callumberry/Mobile-Robot/prototype/README.md

[Home](main)

# Cardboard Prototype
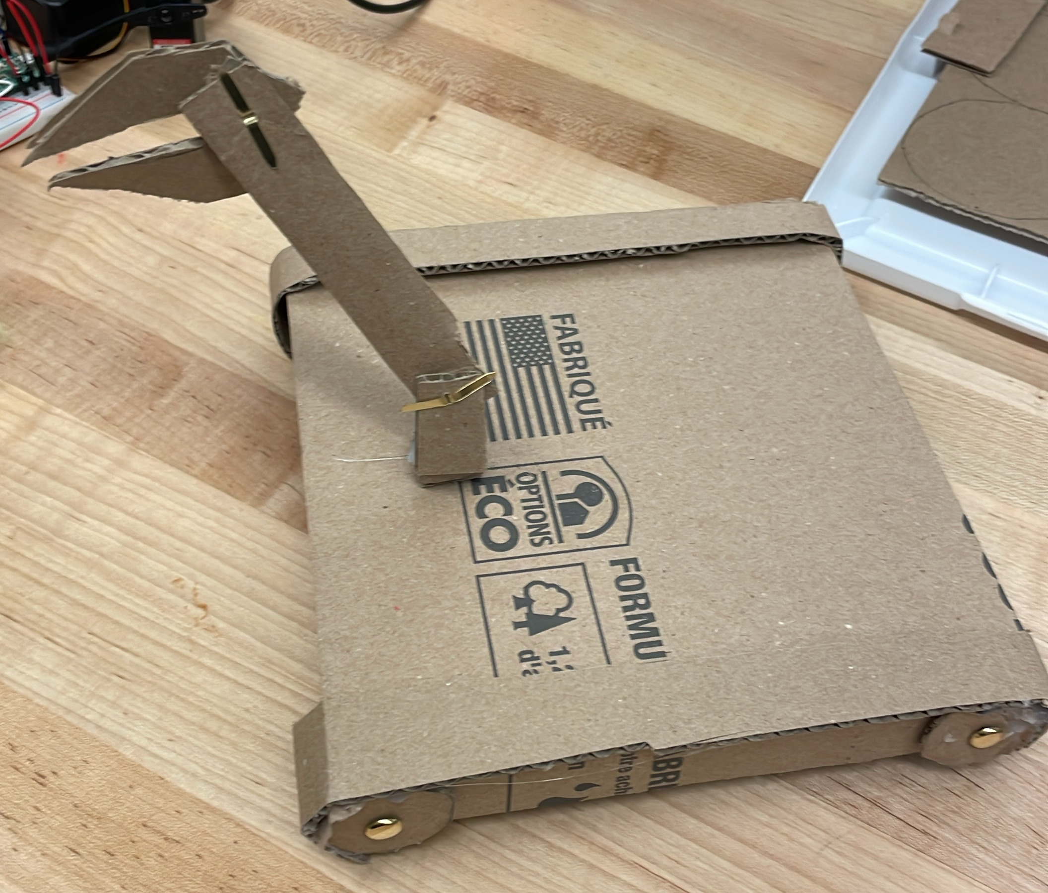
[picture p4: images/prototype/cardboardPro.jpeg]


# Electrical Schematic
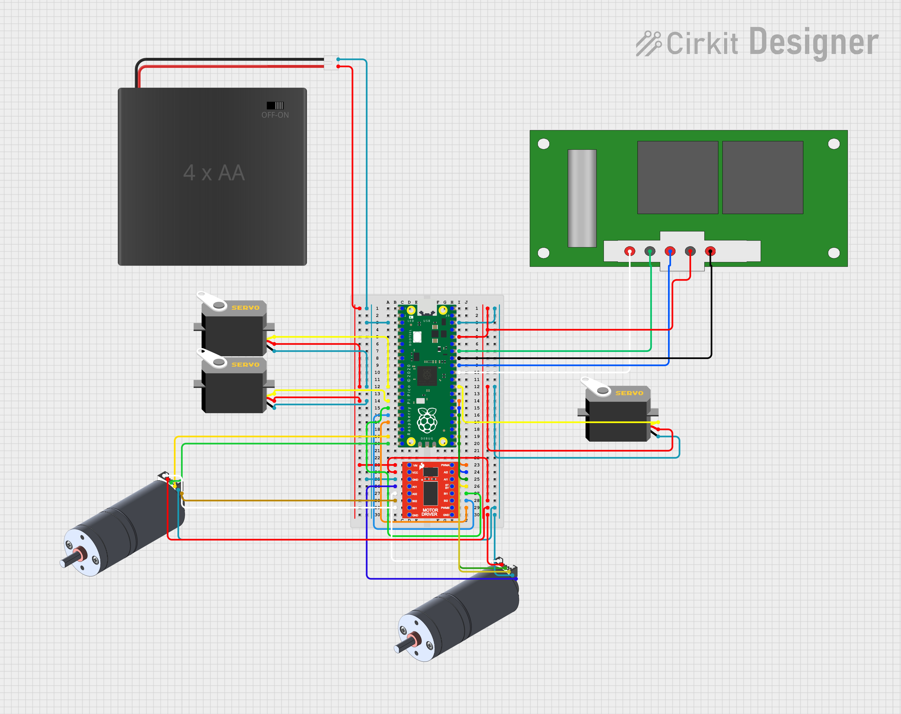
[picture p5: images/prototype/electricalSch.png]


# Electrical Wiring/
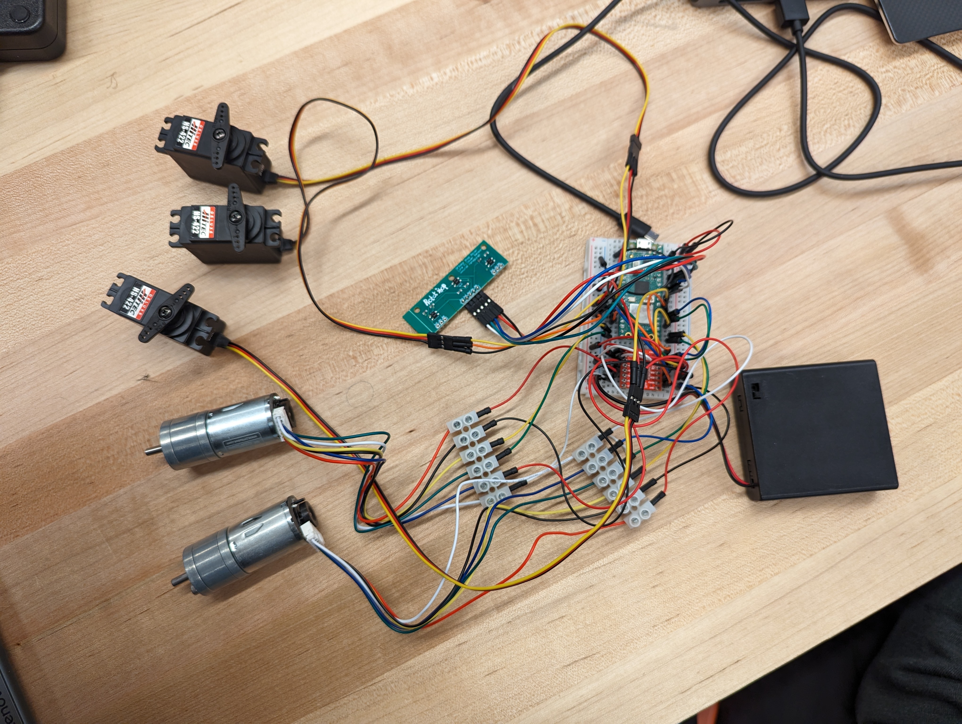
[picture p6: images/prototype/electrical.jpg]


# Arm V1


# Robot w/ Arm V2 + Claw
