callumberry/Mobile-Robot/design_files/CAD/README.md

[Home](main)

# Assembly Pictures
## Arm V1
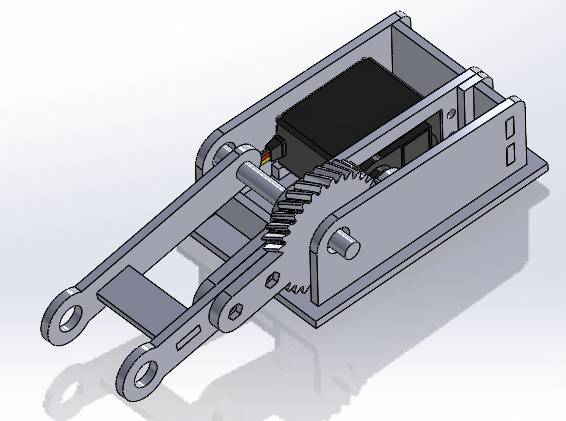
[picture p7: images/solidworks/armV1.png]


## Arm V2
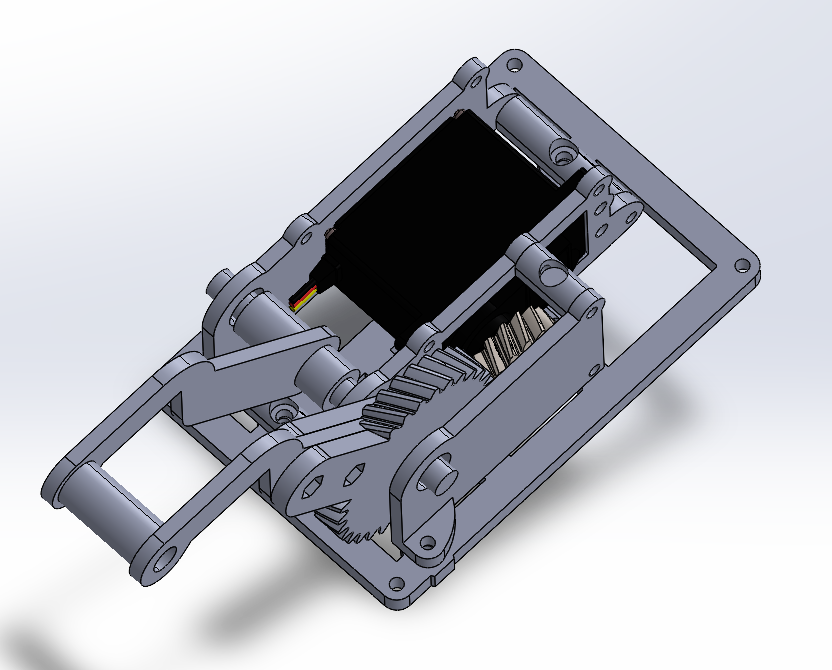
[picture p8: images/solidworks/armAssemblyV2.png]


## Claw
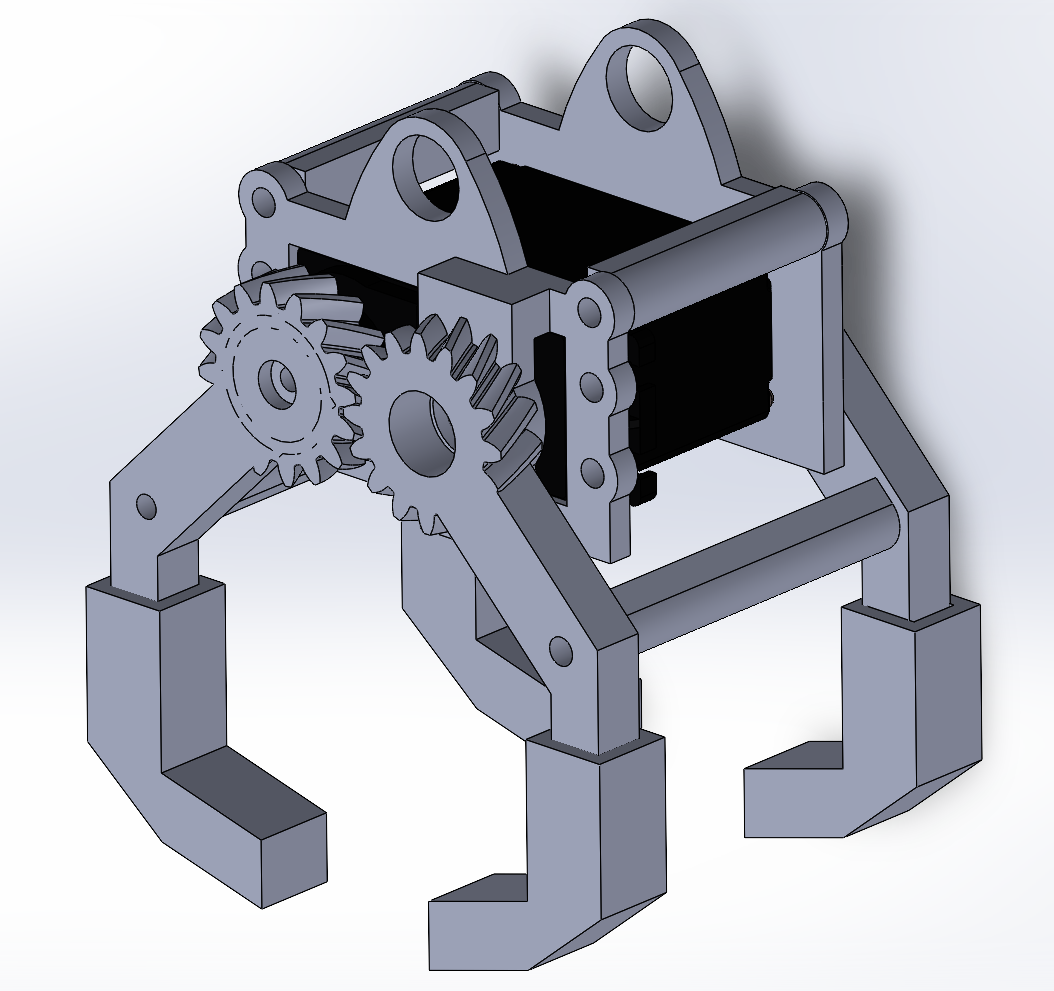
[picture p9: images/solidworks/clawAssembly.png]


## Robot
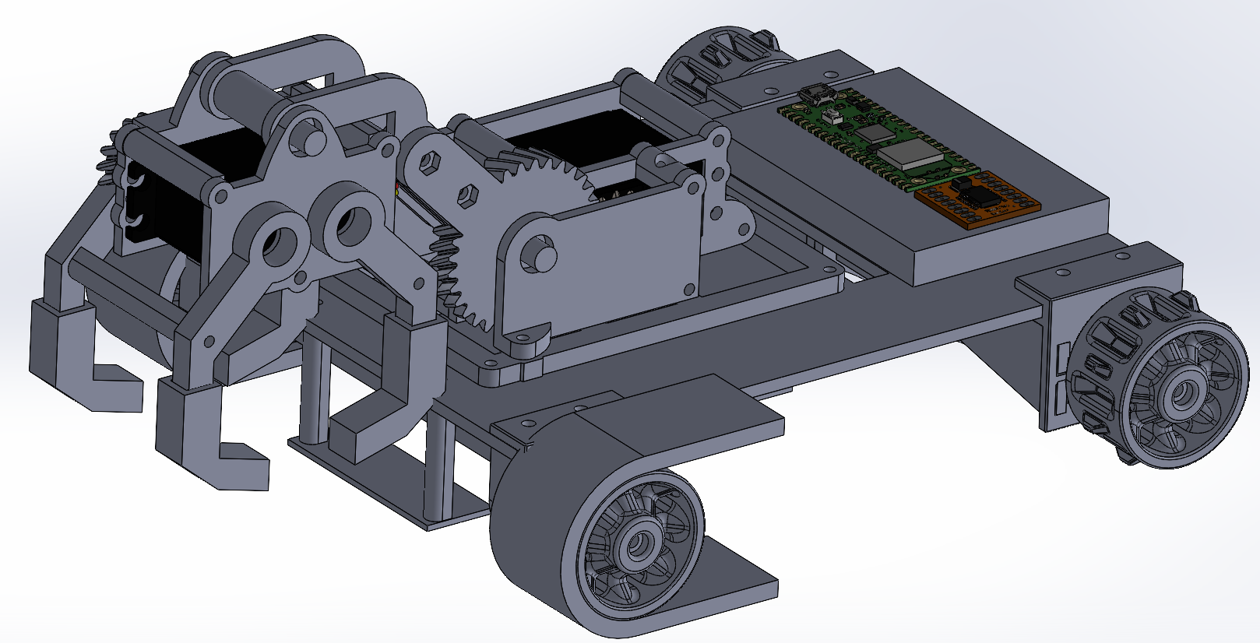
[picture p10: images/solidworks/robotAssembly.png]
