callumberry/Mobile-Robot/design_files/laser_cutting/README.md

[Home](main)

# Pictures
## Chassis
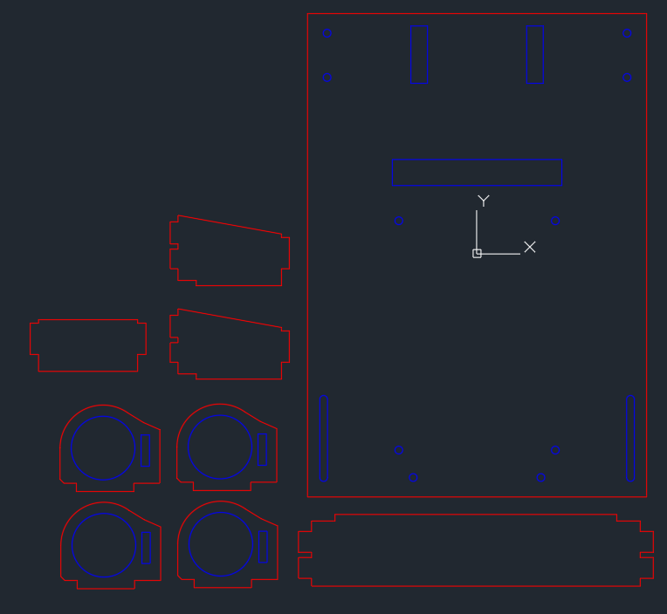
[picture p11: images/dwg/chassis.png]


## Arm V1
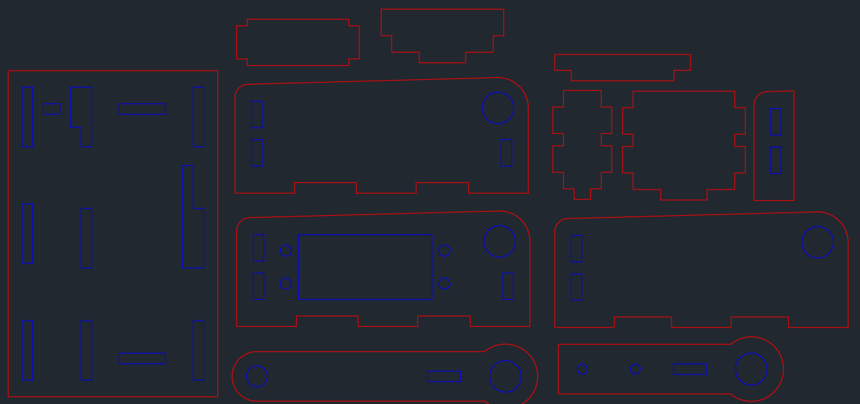
[picture p12: images/dwg/arm.png]


## Chassis and Arm Base V2
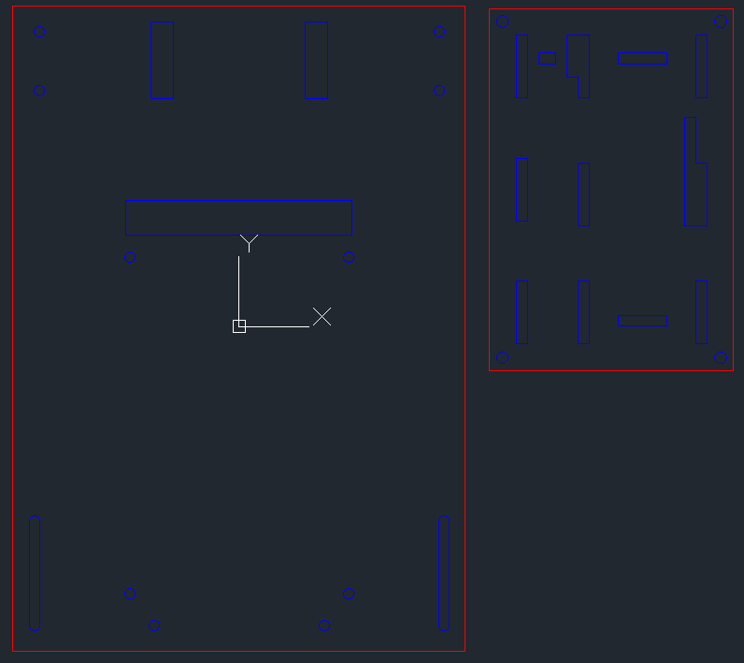
[picture p13: images/dwg/chassis_baseV2.png]
