callumberry/Mobile-Robot/design_files/CAD/Current/Arm/leftarm.SLDASM

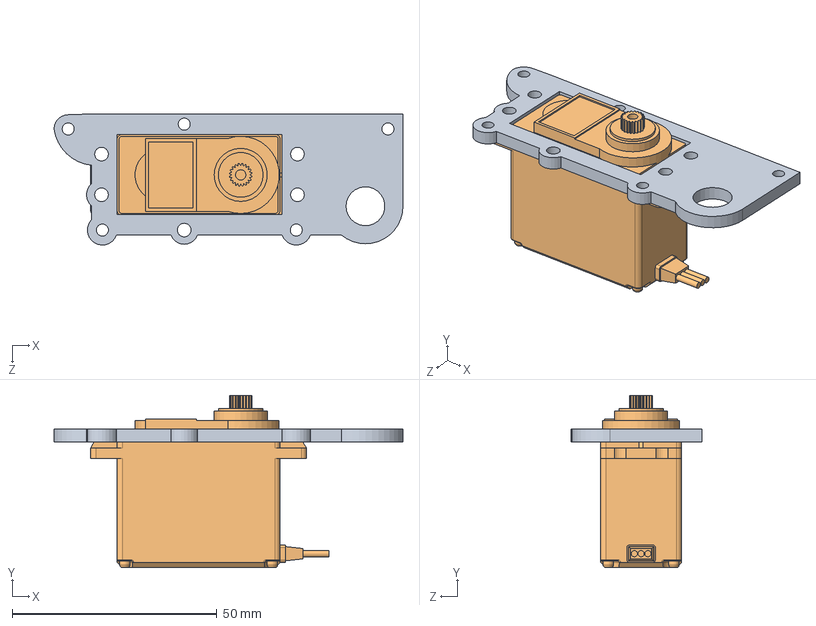
[picture p20: CAD file, 2024-03-31]
design_files/CAD/Current/Arm/leftarm.SLDASM
85.3 x 42.1 x 32.1 mm
HS-422_Servo
servoPlateV2
