callumberry/Mobile-Robot/design_files/CAD/Assemblies/DriveTrain.SLDASM

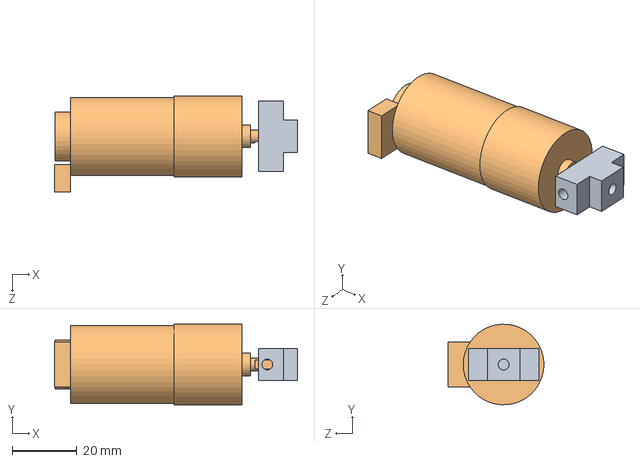
[picture p21: CAD file, 2024-03-23]
design_files/CAD/Assemblies/DriveTrain.SLDASM
75.0 x 24.9 x 29.5 mm
DC_Motor
GrubTestFinal
