callumberry/Mobile-Robot/design_files/CAD/Current/Other/linefollowing.SLDASM

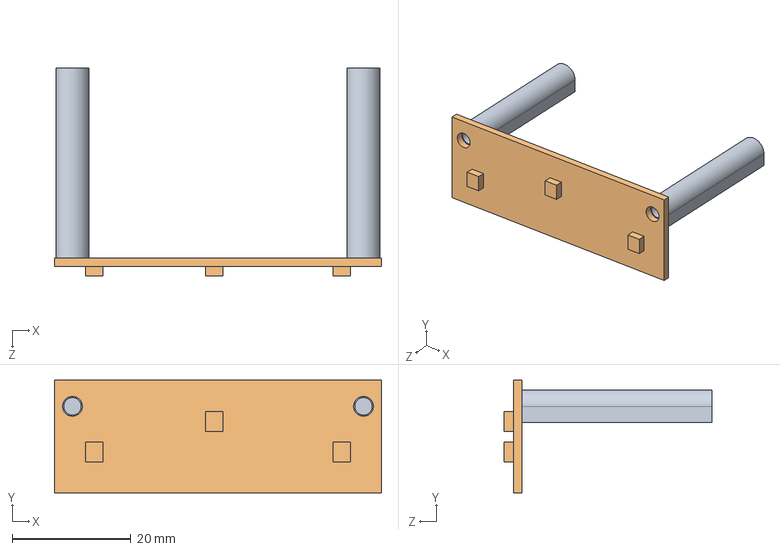
[picture p22: CAD file, 2024-03-31]
design_files/CAD/Current/Other/linefollowing.SLDASM
55.0 x 19.0 x 35.1 mm
sensor
sensorSpacer x 2
