callumberry/Mobile-Robot/design_files/CAD/Parts/ChassisTopIncomplete.SLDPRT

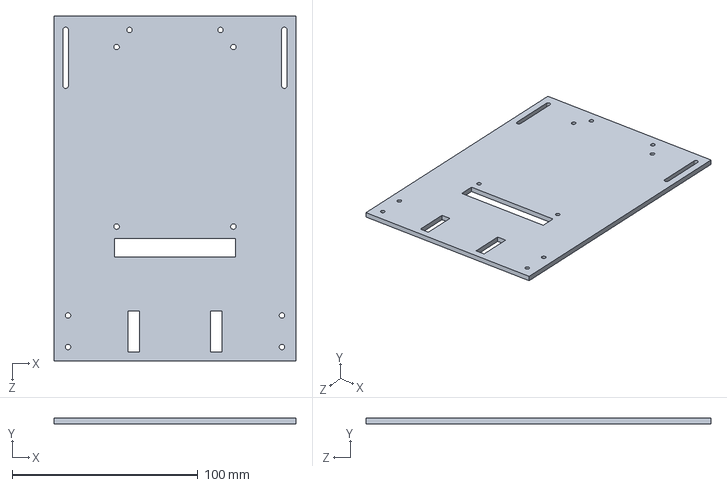
[picture p23: CAD file, 2024-03-31]
design_files/CAD/Parts/ChassisTopIncomplete.SLDPRT
130.0 x 3.17 x 185.5 mm
