callumberry/Mobile-Robot/design_files/CAD/Current/Arm/arm2.SLDASM

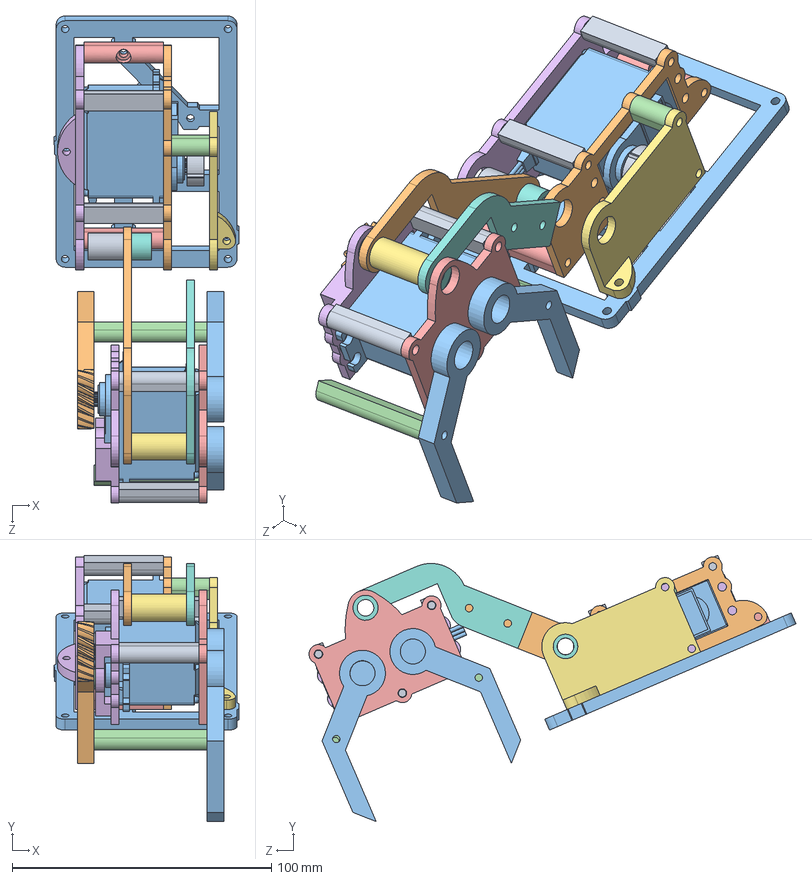
[picture p24: CAD file, 2024-03-31]
design_files/CAD/Current/Arm/arm2.SLDASM
71.2 x 102.6 x 187.7 mm
HS-422_Servo x 2
servoPlateV2
gearSmall x 2
Gearlinkage
GearPlate
servoPlateV2OtherSideBetter
ArmSupport x 2
ArmSupportGear
base
Newlinkage
linkageALign1
linkageALign2
gripperLinkageMiddel
gripperPlate
fingerPlateV2
fingersupprt x 2
roundFingerMotor x 2
smallGearWithservo
gripperSupport x 5
