callumberry/Mobile-Robot/design_files/CAD/Current/Gripper/clawRight.SLDASM

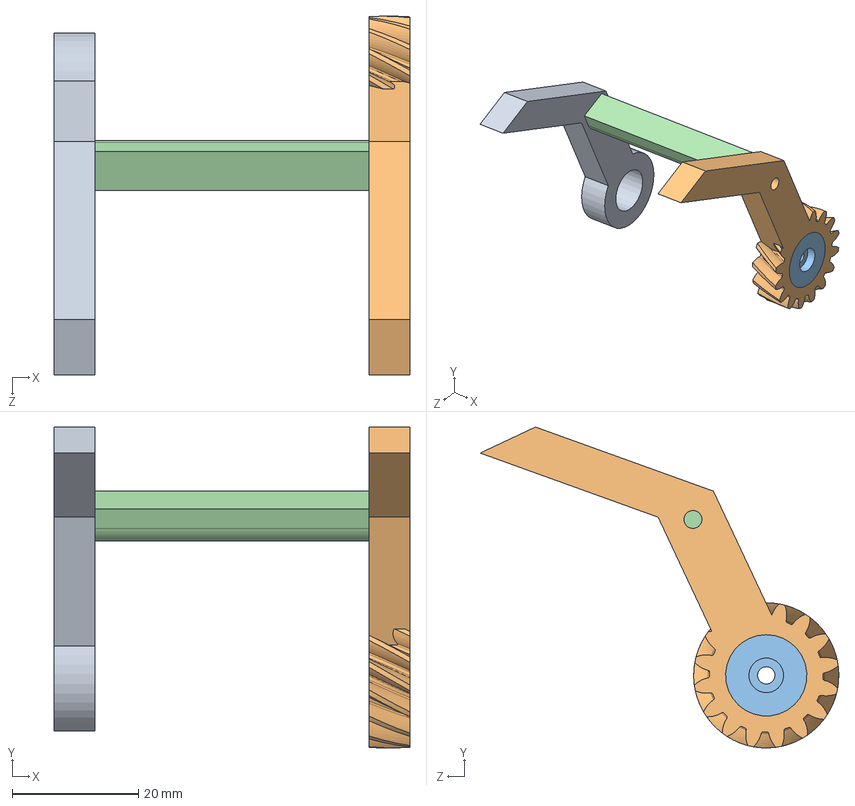
[picture p25: CAD file, 2024-03-31]
design_files/CAD/Current/Gripper/clawRight.SLDASM
56.5 x 50.9 x 56.9 mm
fingersupprt
gearSmall
smallGearWithservo
roundFingerMotor
