callumberry/Mobile-Robot/design_files/CAD/Current/Gripper/Gripper2.SLDASM

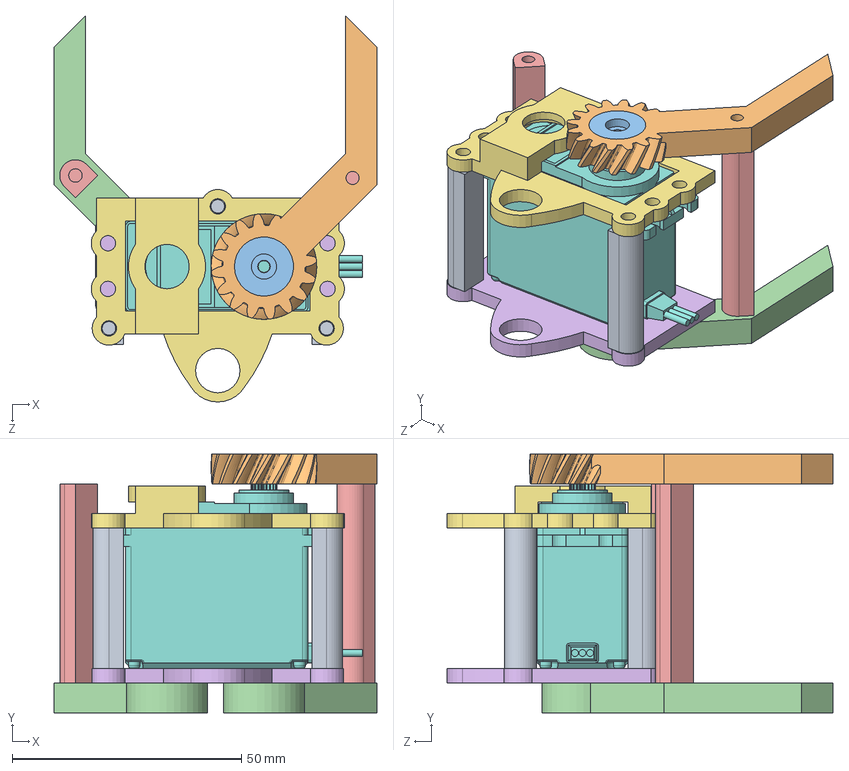
[picture p26: CAD file, 2024-03-31]
design_files/CAD/Current/Gripper/Gripper2.SLDASM
70.4 x 56.5 x 84.2 mm
HS-422_Servo
gripperPlate
fingerPlateV2
fingersupprt x 2
roundFingerMotor x 2
gearSmall
smallGearWithservo
gripperSupport x 3
