callumberry/Mobile-Robot/design_files/CAD/Current/Gripper/clawLeft.SLDASM

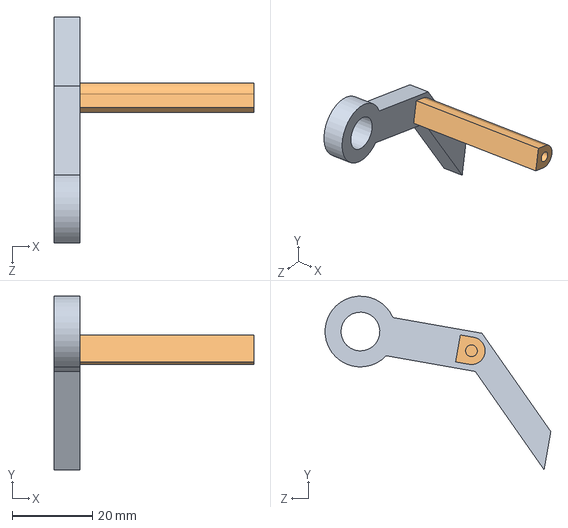
[picture p27: CAD file, 2024-03-31]
design_files/CAD/Current/Gripper/clawLeft.SLDASM
50.0 x 43.4 x 56.4 mm
fingersupprt
roundFingerMotor
