callumberry/Mobile-Robot/design_files/3D_printing/3mf/sleeves.3mf

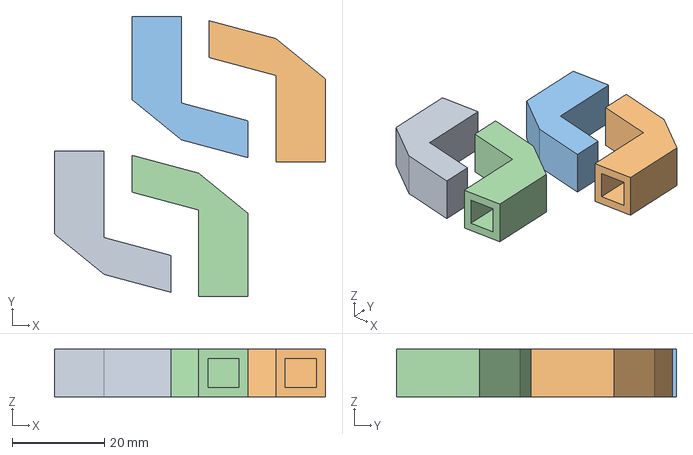
[picture p28: CAD file, 2024-03-31]
design_files/3D_printing/3mf/sleeves.3mf
58.8 x 60.7 x 10.4 mm
sleeve x 4
