callumberry/Mobile-Robot/design_files/CAD/Components/HS-422_Servo.SLDPRT

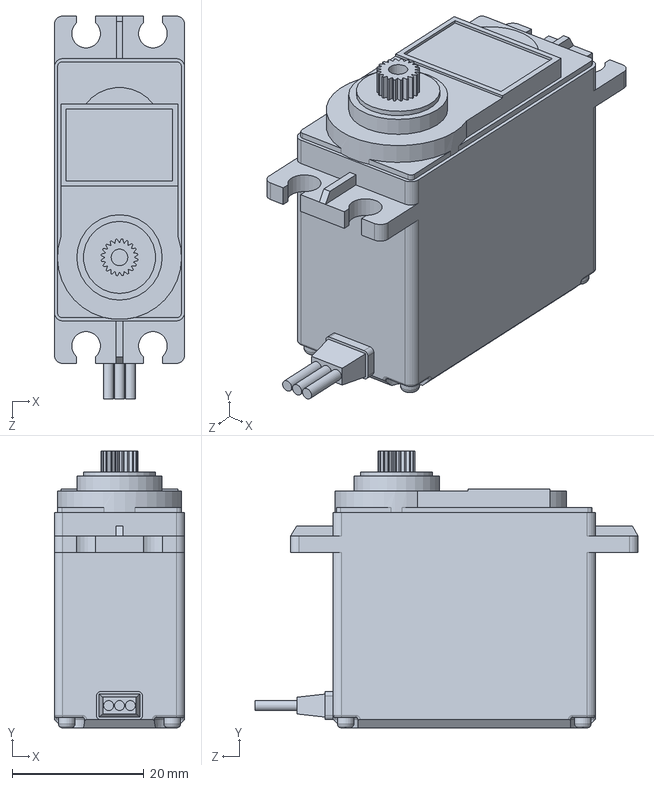
[picture p29: CAD file, 2024-03-23]
design_files/CAD/Components/HS-422_Servo.SLDPRT
19.8 x 42.1 x 58.2 mm
