callumberry/Mobile-Robot/design_files/CAD/Current/Gripper/fingersupprt.SLDPRT

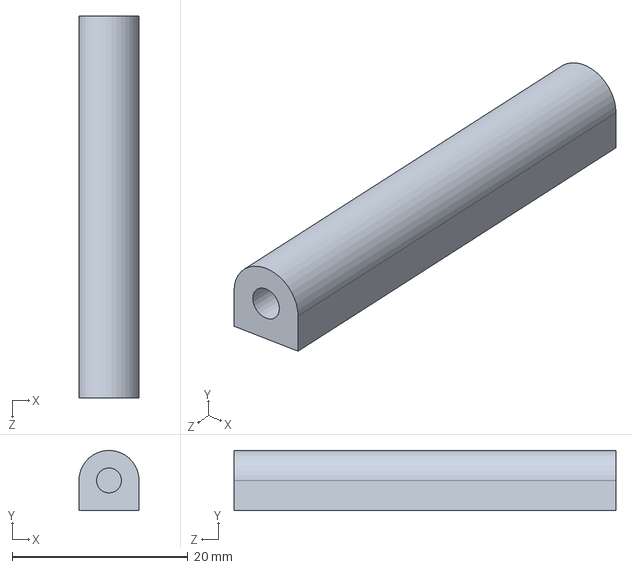
[picture p30: CAD file, 2024-03-31]
design_files/CAD/Current/Gripper/fingersupprt.SLDPRT
6.85 x 6.84 x 43.5 mm
