callumberry/Mobile-Robot/design_files/CAD/Current/linkageALign1.SLDPRT

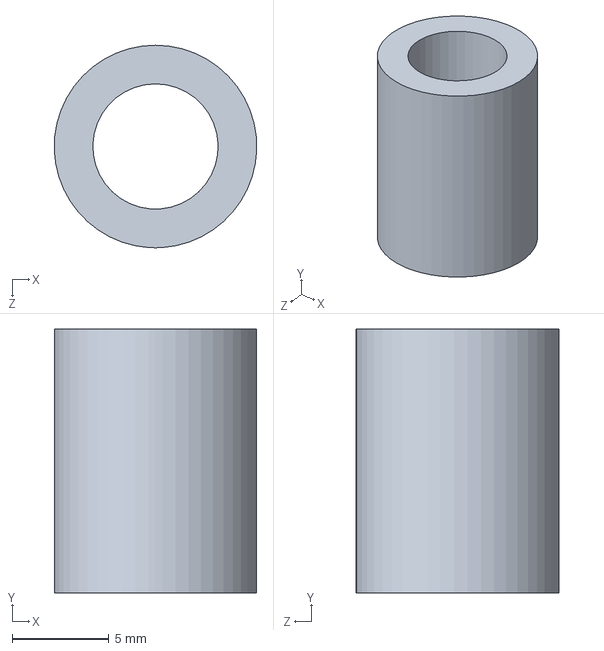
[picture p31: CAD file, 2024-03-31]
design_files/CAD/Current/linkageALign1.SLDPRT
10.5 x 13.6 x 10.5 mm
