callumberry/Mobile-Robot/design_files/CAD/Current/Other/endcap.SLDPRT

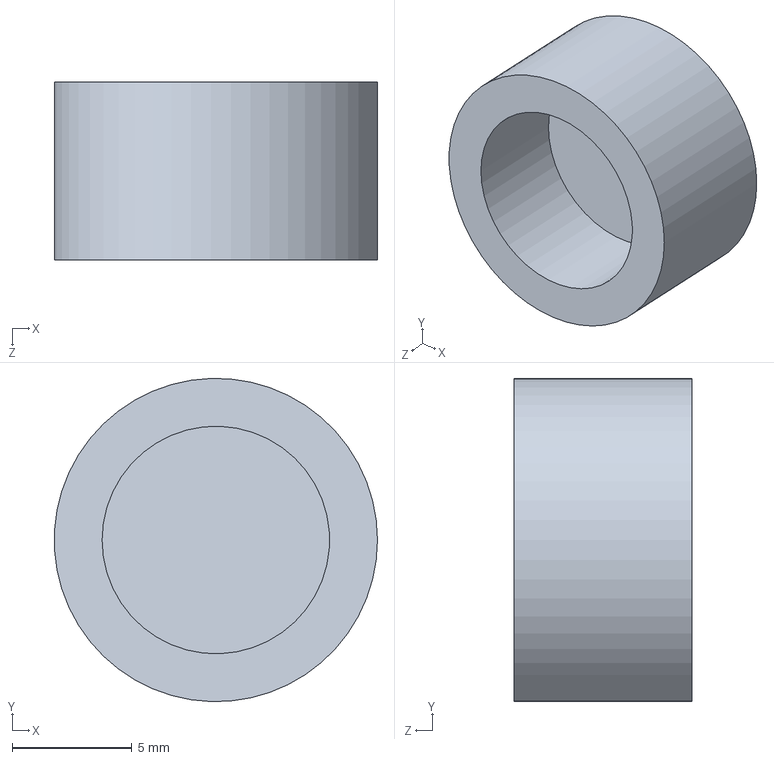
[picture p32: CAD file, 2024-03-31]
design_files/CAD/Current/Other/endcap.SLDPRT
13.5 x 13.5 x 7.43 mm
