callumberry/Mobile-Robot/design_files/CAD/Finished/TreadsFeb22_2024.3mf

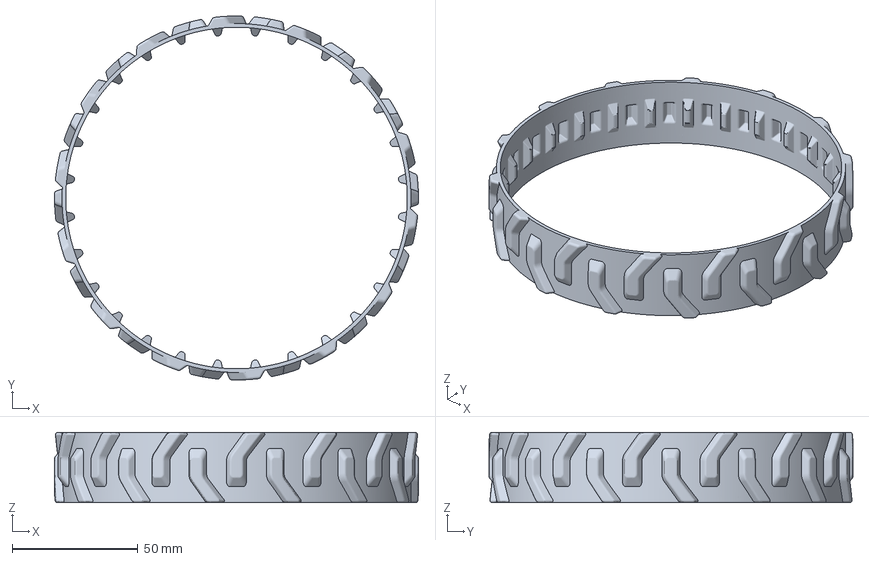
[picture p33: CAD file, 2024-03-31]
design_files/CAD/Finished/TreadsFeb22_2024.3mf
145.0 x 145.0 x 28.0 mm
