callumberry/Mobile-Robot/design_files/CAD/Parts/smallGearWithservo.SLDPRT

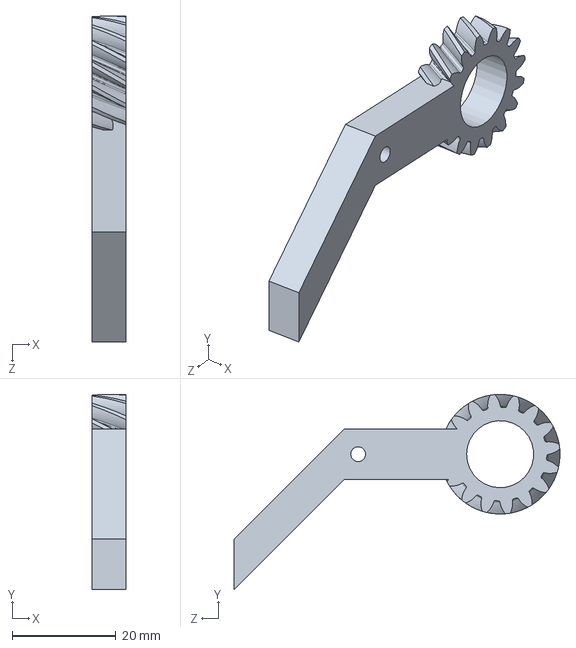
[picture p34: CAD file, 2024-03-31]
design_files/CAD/Parts/smallGearWithservo.SLDPRT
6.47 x 37.6 x 62.7 mm
