callumberry/Mobile-Robot/design_files/3D_printing/3mf/idlePincers.3mf

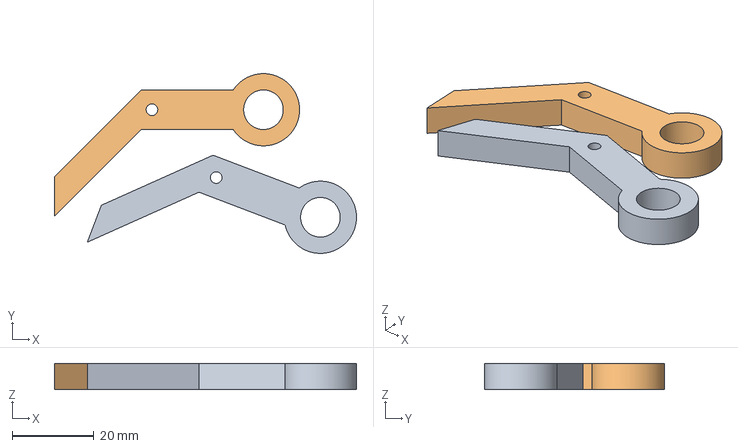
[picture p35: CAD file, 2024-03-31]
design_files/3D_printing/3mf/idlePincers.3mf
74.0 x 44.1 x 6.47 mm
roundFingerMotor x 2
