callumberry/Mobile-Robot/design_files/CAD/Components/DC_Motor.SLDPRT

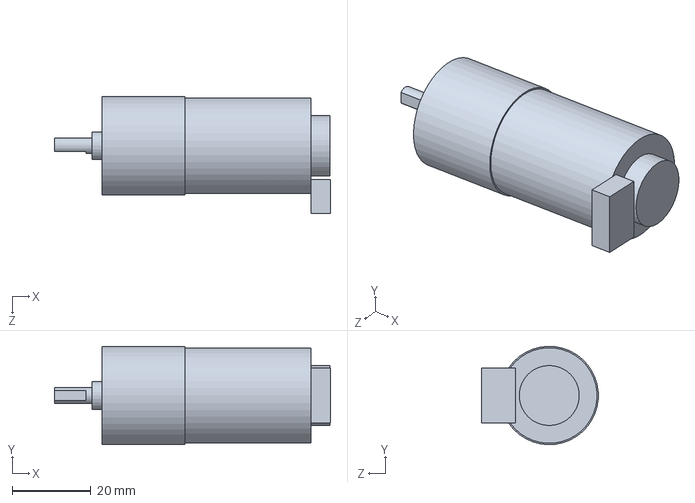
[picture p36: CAD file, 2024-01-29]
design_files/CAD/Components/DC_Motor.SLDPRT
69.9 x 24.9 x 29.5 mm
