callumberry/Mobile-Robot/design_files/CAD/Current/base.SLDPRT

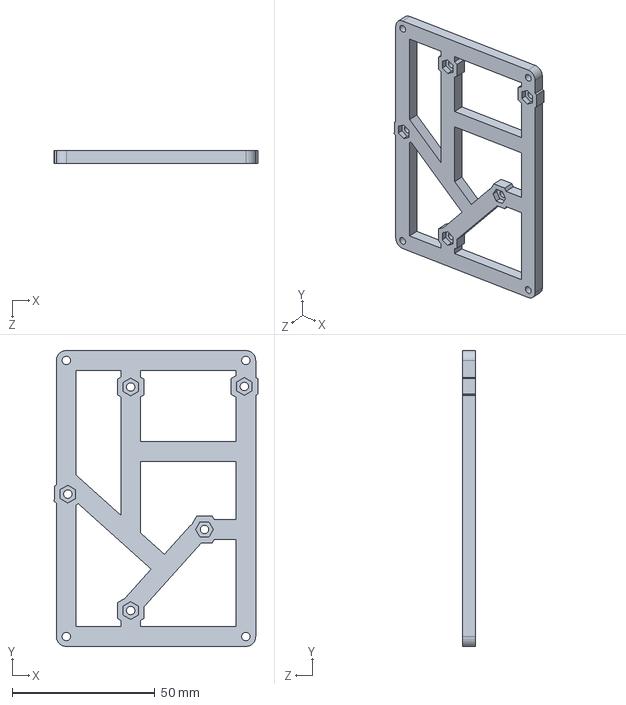
[picture p37: CAD file, 2024-03-31]
design_files/CAD/Current/base.SLDPRT
71.2 x 103.5 x 4.60 mm
