callumberry/Mobile-Robot/design_files/CAD/Current/Gripper/fingerPlateV2.SLDPRT

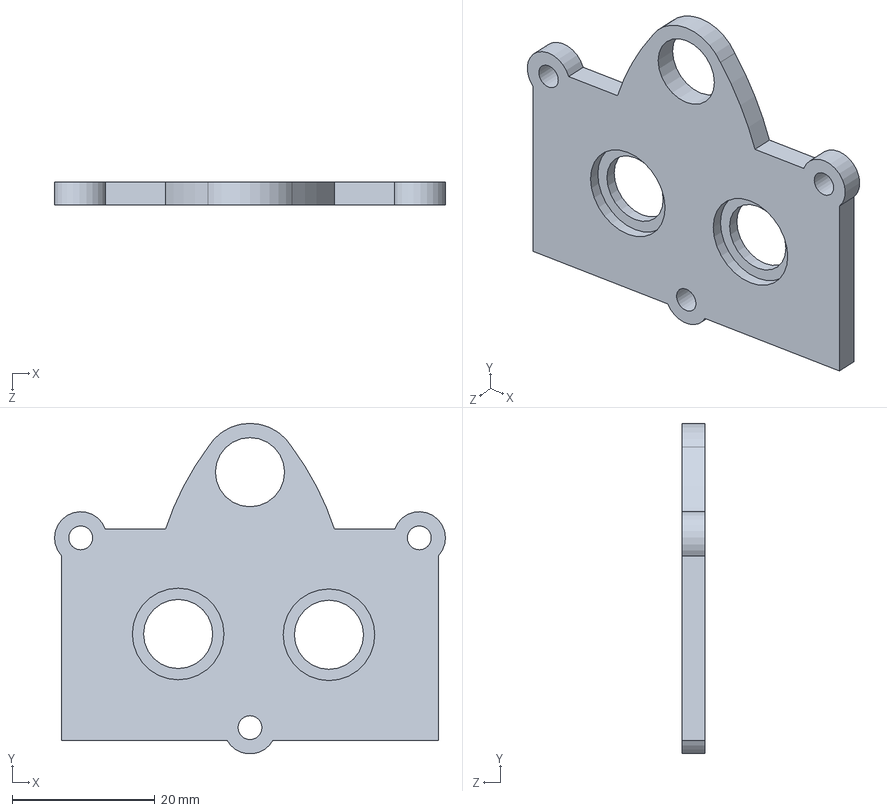
[picture p38: CAD file, 2024-03-31]
design_files/CAD/Current/Gripper/fingerPlateV2.SLDPRT
54.8 x 46.3 x 3.20 mm
