callumberry/Mobile-Robot/design_files/CAD/Xtra/ToleranceTests/hexTest.SLDPRT

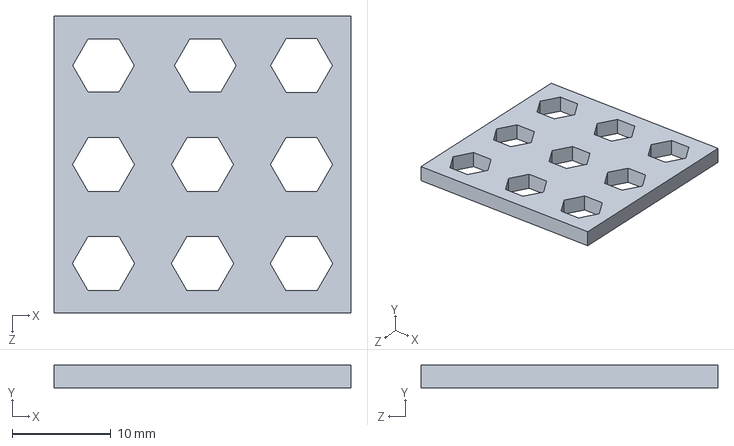
[picture p40: CAD file, 2024-03-23]
design_files/CAD/Xtra/ToleranceTests/hexTest.SLDPRT
30.0 x 2.30 x 30.0 mm
