callumberry/Mobile-Robot/design_files/3D_printing/3mf/armV2.3mf

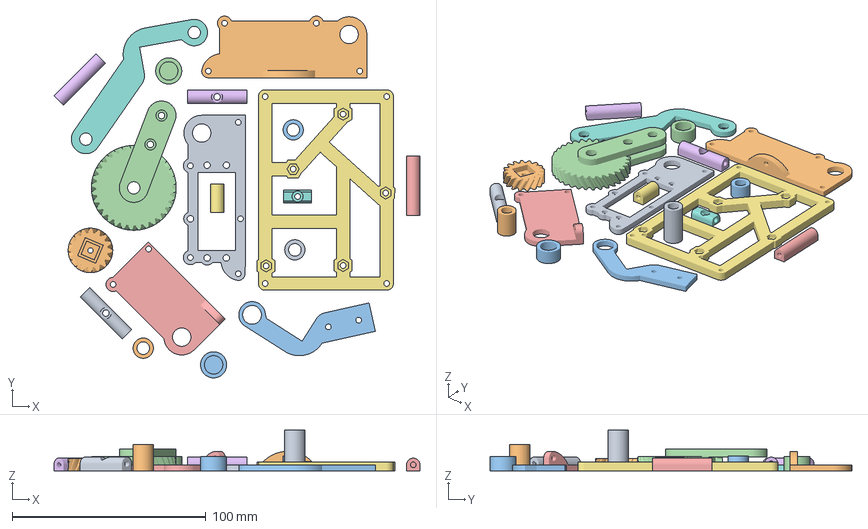
[picture p41: CAD file, 2024-03-31]
design_files/3D_printing/3mf/armV2.3mf
189.0 x 186.8 x 21.1 mm
print2
prnt3
endcap x 2
GearPlate
ArmSupport x 2
ArmSupportGear
ArmSupportGearScrew
motorGear
Gearlinkage
bigGear
gripperSupport x 2
base
Newlinkage
gripperLinkageMiddel
linkageALign1
linkageALign2
