callumberry/Mobile-Robot/design_files/CAD/Components/MotorDriver.SLDPRT

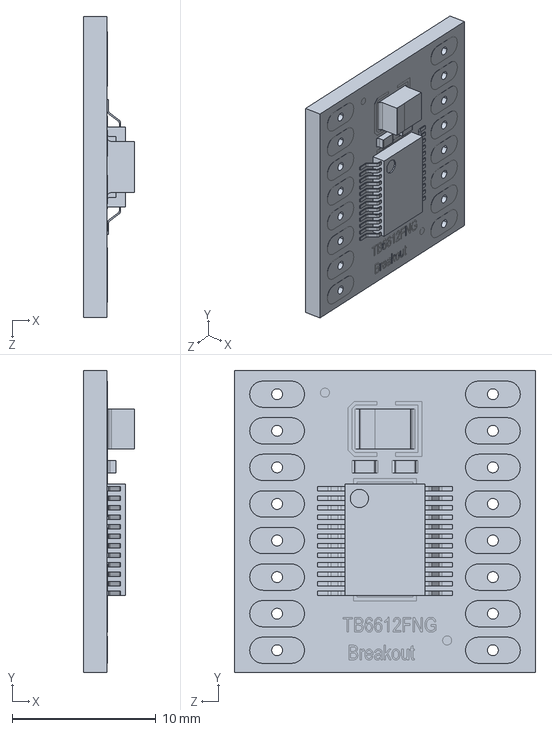
[picture p42: CAD file, 2024-01-29]
design_files/CAD/Components/MotorDriver.SLDPRT
3.57 x 21.0 x 20.9 mm
