callumberry/Mobile-Robot/design_files/CAD/Current/Arm/Gearlinkage.SLDPRT

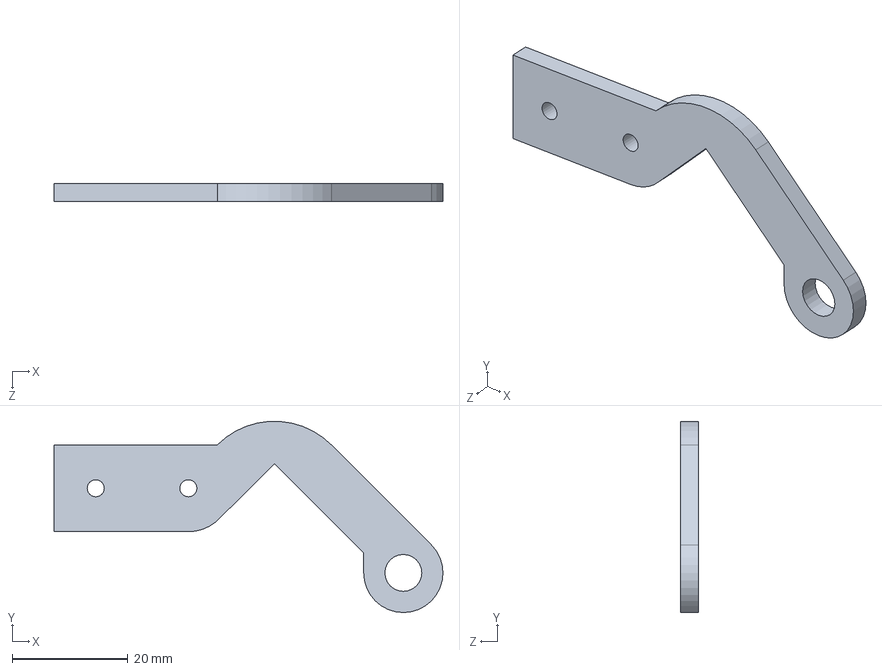
[picture p43: CAD file, 2024-03-31]
design_files/CAD/Current/Arm/Gearlinkage.SLDPRT
67.2 x 33.0 x 3.17 mm
