callumberry/Mobile-Robot/design_files/CAD/Current/Gripper/gripperSupport.SLDPRT

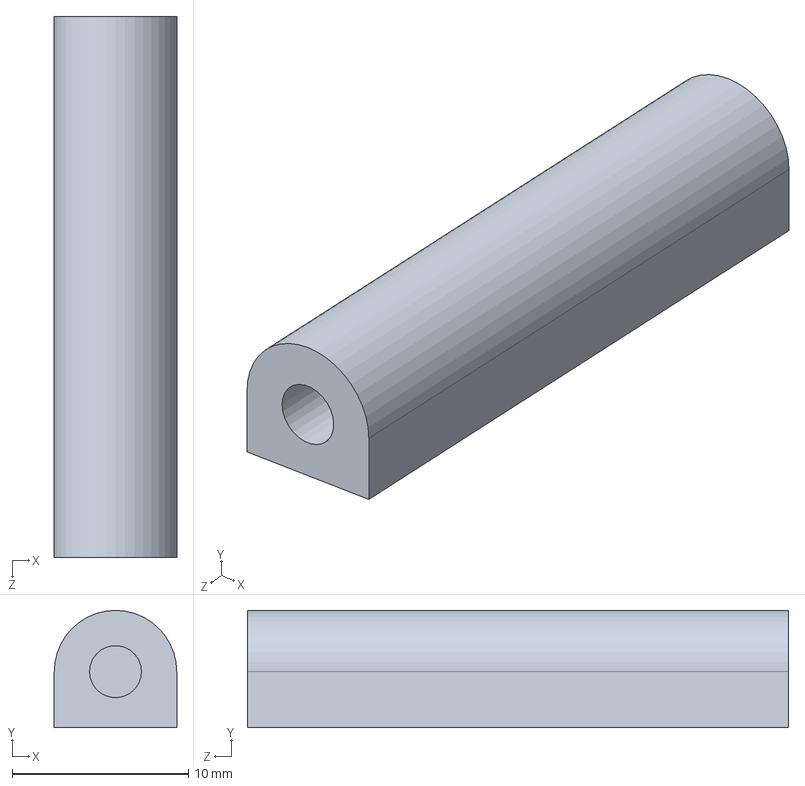
[picture p44: CAD file, 2024-03-31]
design_files/CAD/Current/Gripper/gripperSupport.SLDPRT
6.95 x 6.65 x 30.7 mm
