callumberry/Mobile-Robot/design_files/CAD/Current/linkageALign2.SLDPRT

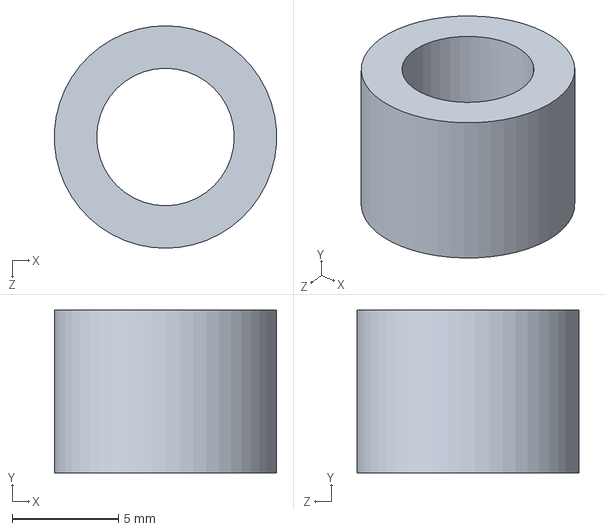
[picture p45: CAD file, 2024-03-31]
design_files/CAD/Current/linkageALign2.SLDPRT
10.5 x 7.66 x 10.5 mm
