callumberry/Mobile-Robot/design_files/CAD/Current/Other/sensorSpacer.SLDPRT

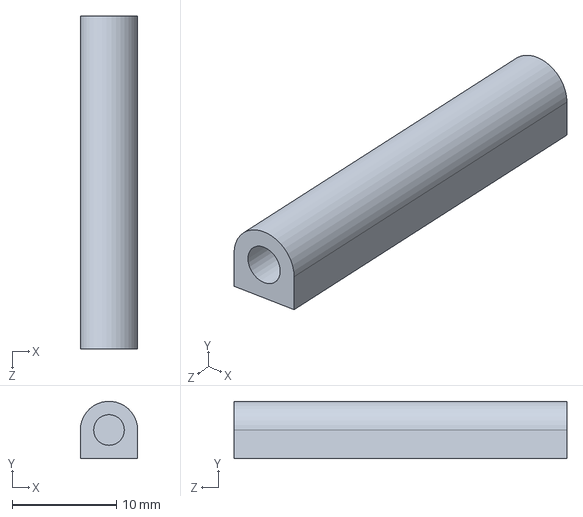
[picture p46: CAD file, 2024-03-31]
design_files/CAD/Current/Other/sensorSpacer.SLDPRT
5.50 x 5.49 x 32.0 mm
