callumberry/Mobile-Robot/design_files/CAD/Parts/roundFingerMotor.SLDPRT

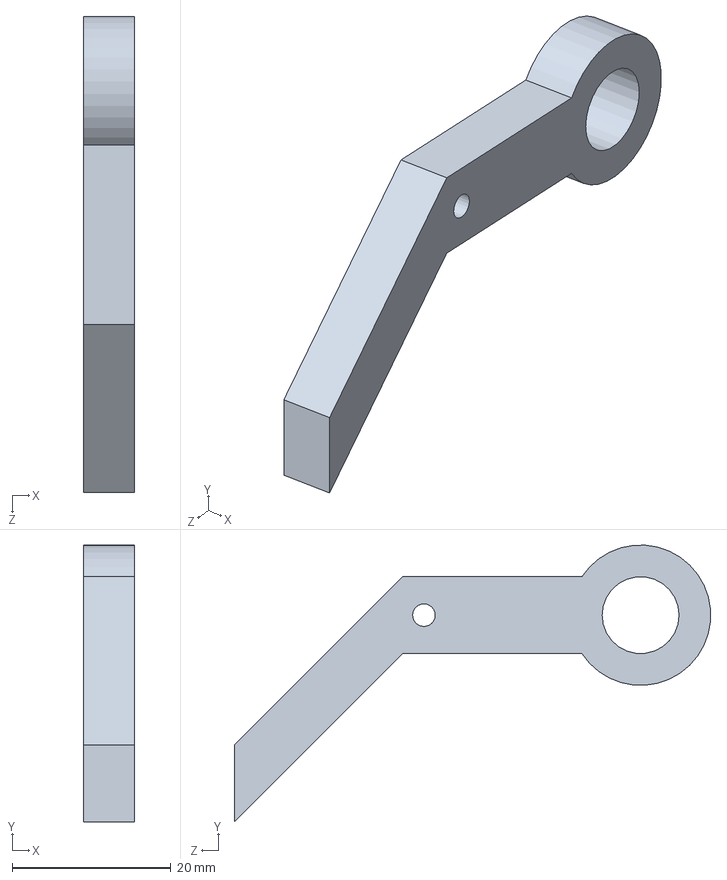
[picture p47: CAD file, 2024-03-31]
design_files/CAD/Parts/roundFingerMotor.SLDPRT
6.47 x 34.9 x 60.0 mm
