callumberry/Mobile-Robot/design_files/3D_printing/3mf/claw.3mf

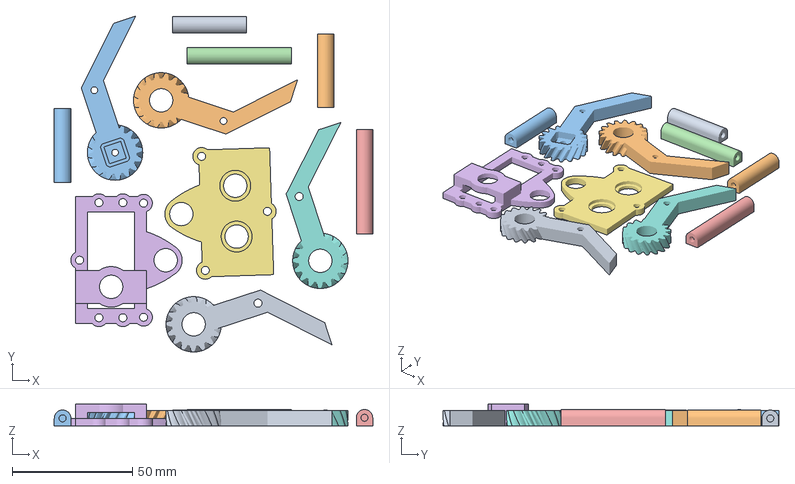
[picture p48: CAD file, 2024-03-31]
design_files/3D_printing/3mf/claw.3mf
132.5 x 139.8 x 9.15 mm
gripperSupport x 3
fingersupprt x 2
gripperPlate
fingerPlateV2
otherFinger x 2
smallGearV2
clawRight
