callumberry/Mobile-Robot/design_files/CAD/Current/Arm/servoPlateV2OtherSideBetter.SLDPRT

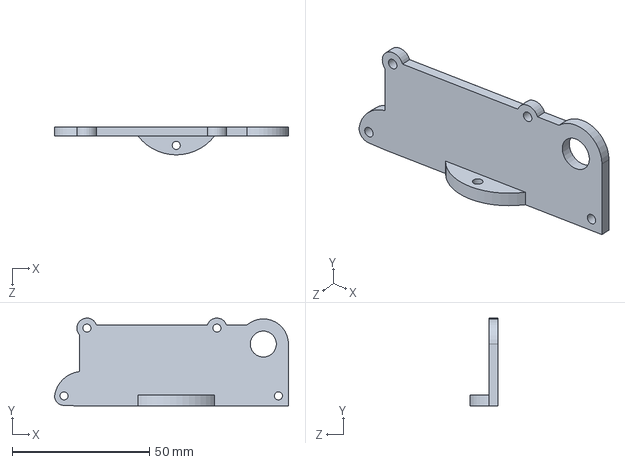
[picture p49: CAD file, 2024-03-31]
design_files/CAD/Current/Arm/servoPlateV2OtherSideBetter.SLDPRT
85.3 x 32.1 x 10.1 mm
