callumberry/Mobile-Robot/design_files/CAD/Current/Gripper/gripperPlate.SLDPRT

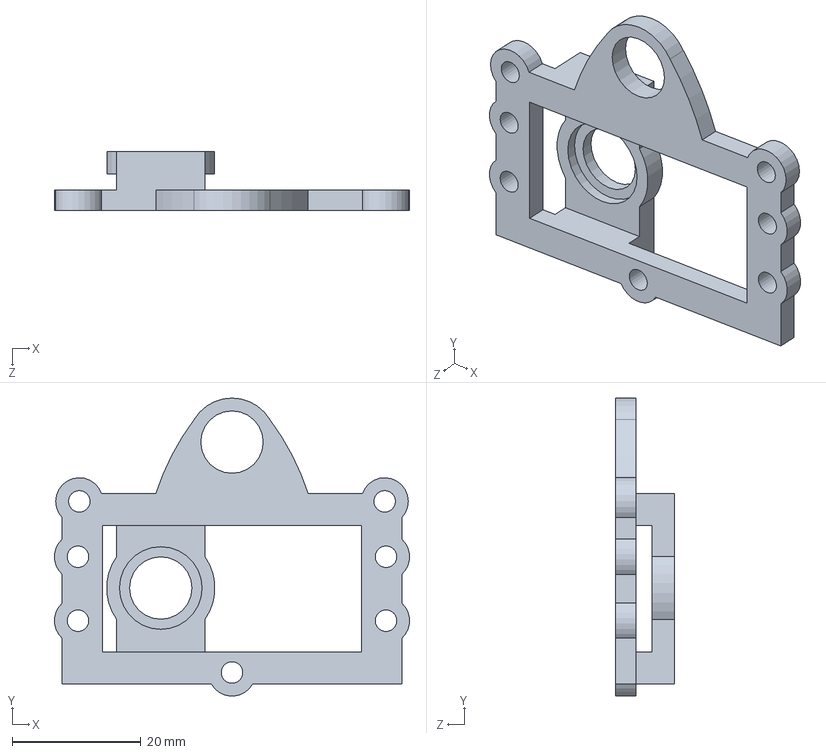
[picture p50: CAD file, 2024-03-31]
design_files/CAD/Current/Gripper/gripperPlate.SLDPRT
55.2 x 46.3 x 9.15 mm
