callumberry/Mobile-Robot/design_files/CAD/Current/gripperLinkageMiddel.SLDPRT

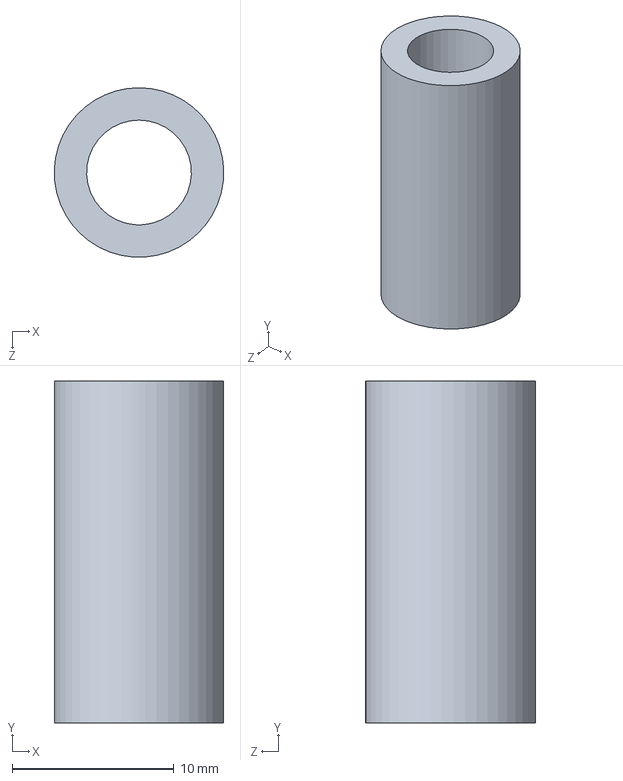
[picture p51: CAD file, 2024-03-31]
design_files/CAD/Current/gripperLinkageMiddel.SLDPRT
10.5 x 21.1 x 10.5 mm
