callumberry/Mobile-Robot/design_files/CAD/Current/Other/sensor.SLDPRT

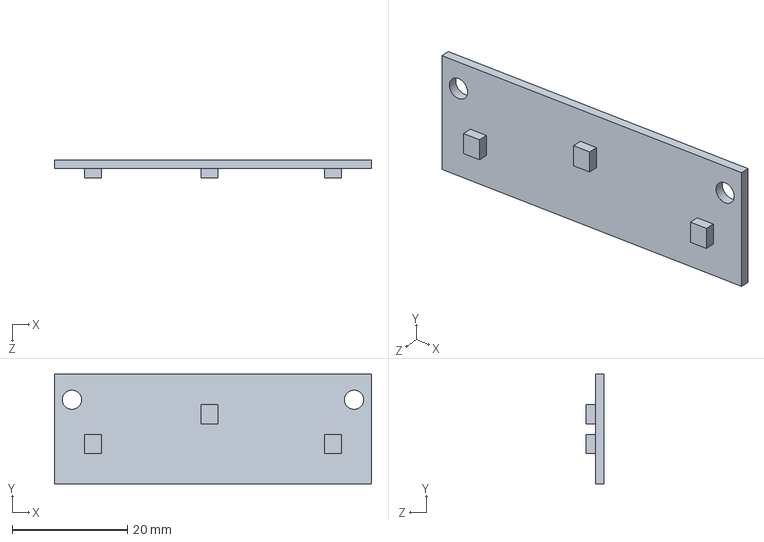
[picture p52: CAD file, 2024-03-23]
design_files/CAD/Current/Other/sensor.SLDPRT
55.0 x 19.0 x 3.10 mm
