callumberry/Mobile-Robot/design_files/3D_printing/3mf/idleShaftV2.3mf

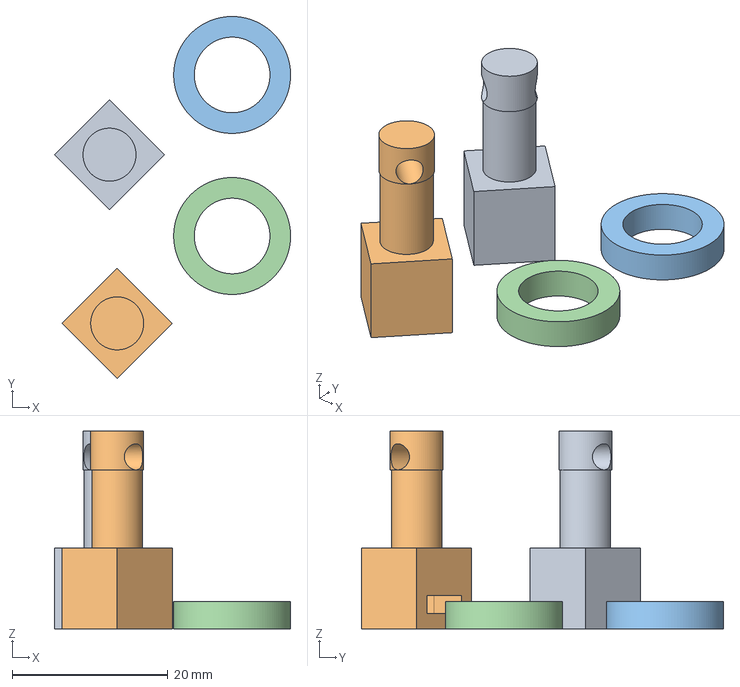
[picture p53: CAD file, 2024-03-31]
design_files/3D_printing/3mf/idleShaftV2.3mf
30.3 x 46.4 x 25.4 mm
IdleGrubTest x 2
Spacer x 2
