callumberry/Mobile-Robot/design_files/CAD/Current/Arm/Newlinkage.SLDPRT

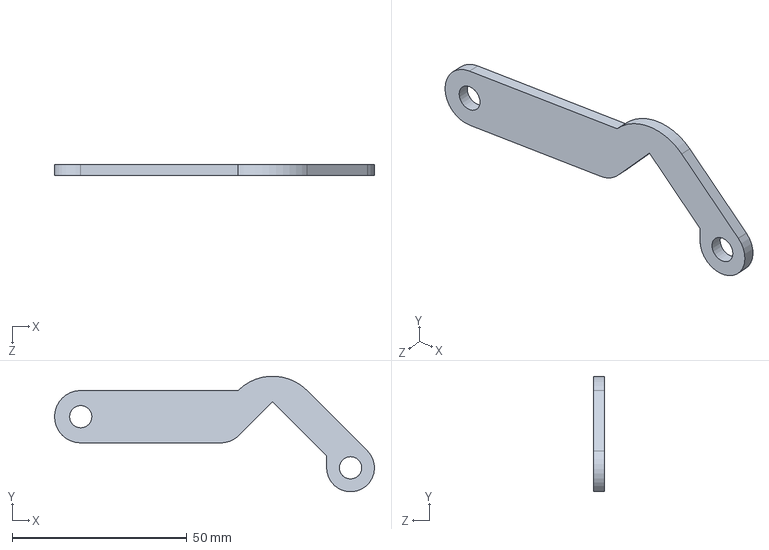
[picture p54: CAD file, 2024-03-31]
design_files/CAD/Current/Arm/Newlinkage.SLDPRT
91.5 x 33.0 x 3.17 mm
