callumberry/Mobile-Robot/design_files/CAD/Current/ArmSupport.SLDPRT

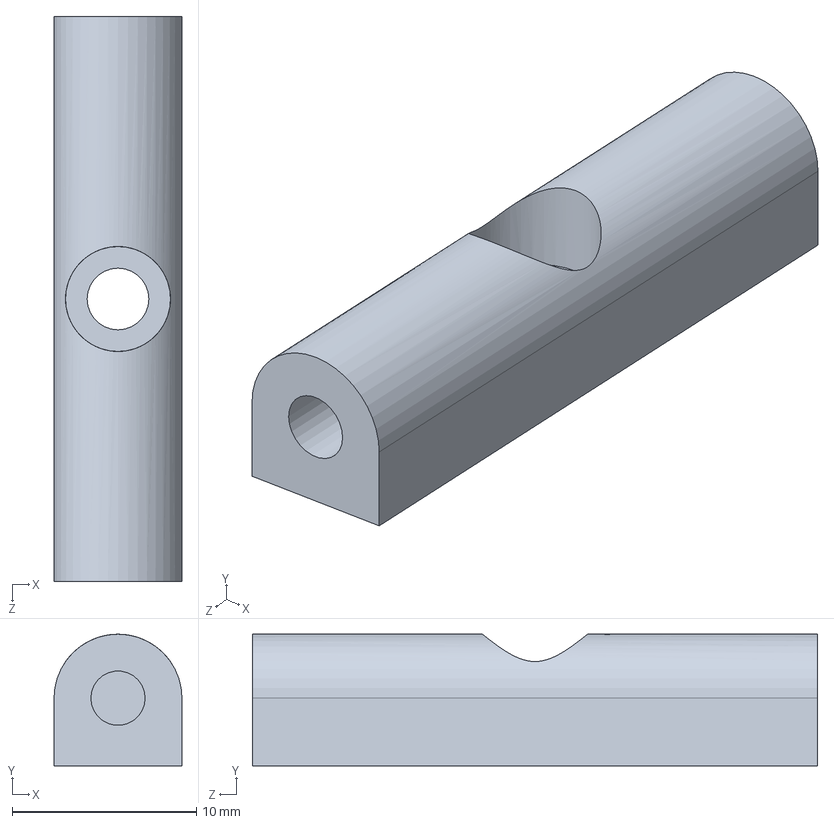
[picture p55: CAD file, 2024-03-31]
design_files/CAD/Current/ArmSupport.SLDPRT
6.95 x 7.15 x 30.7 mm
