callumberry/Mobile-Robot/design_files/CAD/Current/Gripper/sleeve.STEP

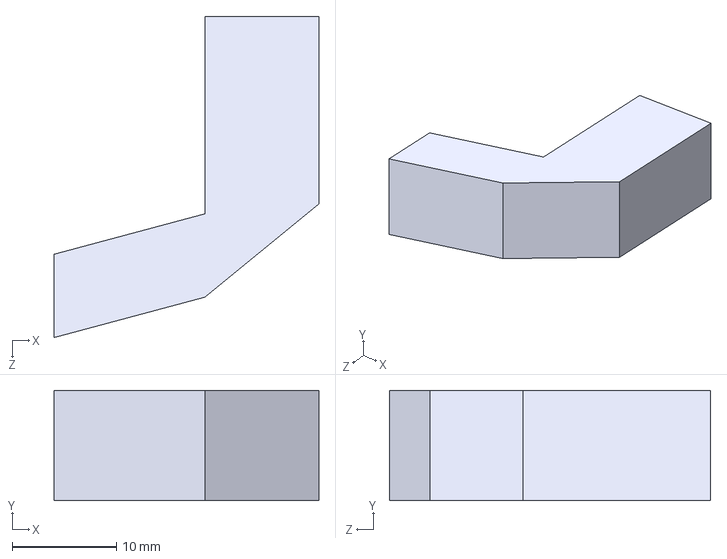
[picture p56: CAD file, 2024-03-31]
design_files/CAD/Current/Gripper/sleeve.STEP
25.4 x 10.6 x 30.8 mm
