callumberry/Mobile-Robot/design_files/CAD/Parts/IdleGrubTest.SLDPRT

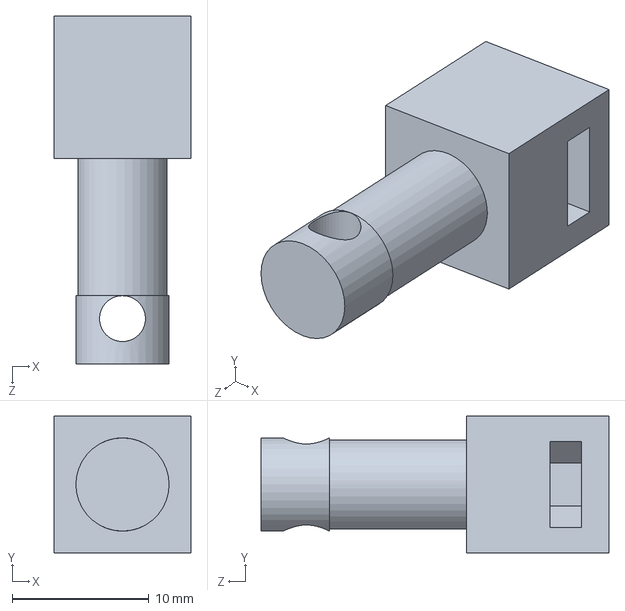
[picture p57: CAD file, 2024-03-23]
design_files/CAD/Parts/IdleGrubTest.SLDPRT
10.0 x 10.0 x 25.4 mm
