callumberry/Mobile-Robot/design_files/3D_printing/3mf/sensorV1.3mf

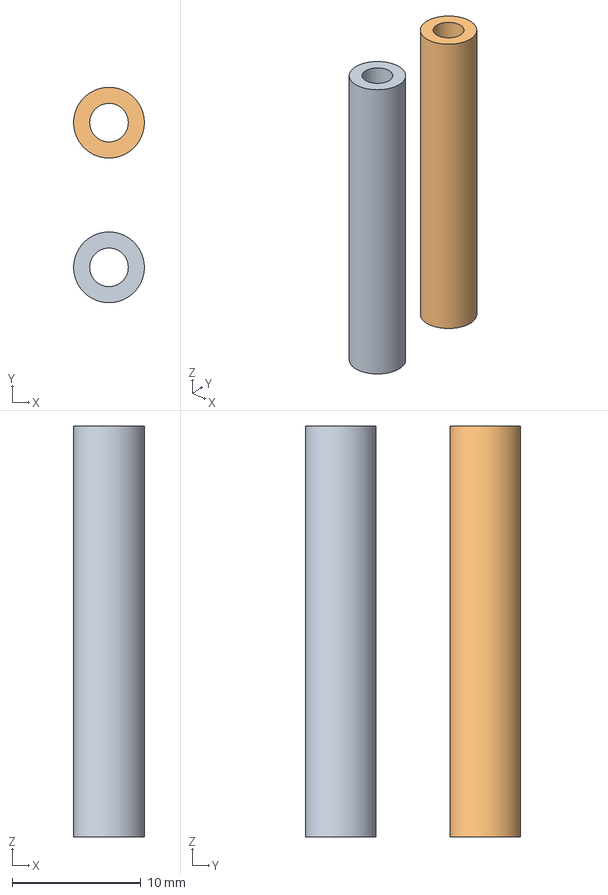
[picture p58: CAD file, 2024-03-31]
design_files/3D_printing/3mf/sensorV1.3mf
5.50 x 16.7 x 32.0 mm
sensorSpacer x 2
