callumberry/Mobile-Robot/design_files/CAD/Current/Arm/servoPlateV2.SLDPRT

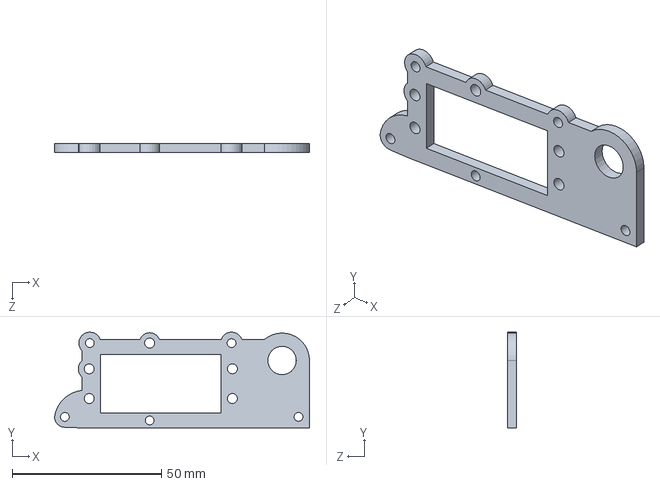
[picture p59: CAD file, 2024-03-31]
design_files/CAD/Current/Arm/servoPlateV2.SLDPRT
85.3 x 32.1 x 3.17 mm
