callumberry/Mobile-Robot/design_files/CAD/Current/Gripper/ken.SLDPRT

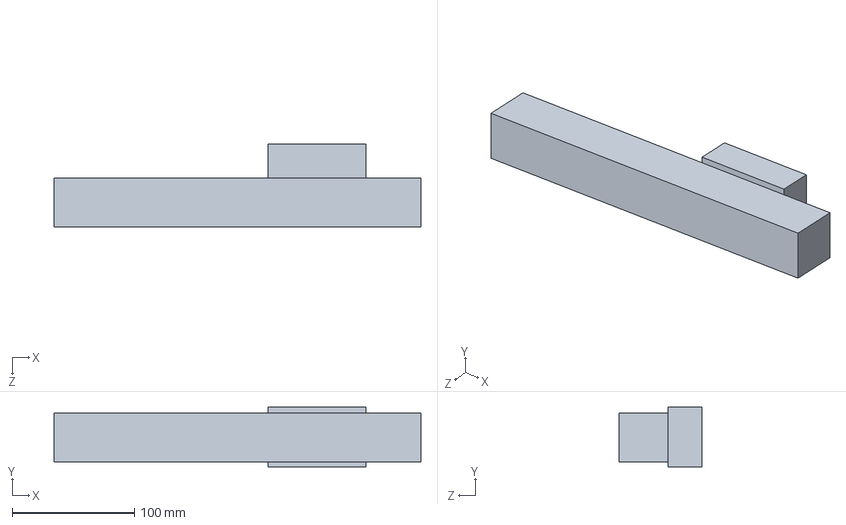
[picture p60: CAD file, 2024-03-31]
design_files/CAD/Current/Gripper/ken.SLDPRT
300.0 x 49.0 x 68.0 mm
