callumberry/Mobile-Robot/design_files/CAD/Parts/IdlePlateMirror.SLDPRT

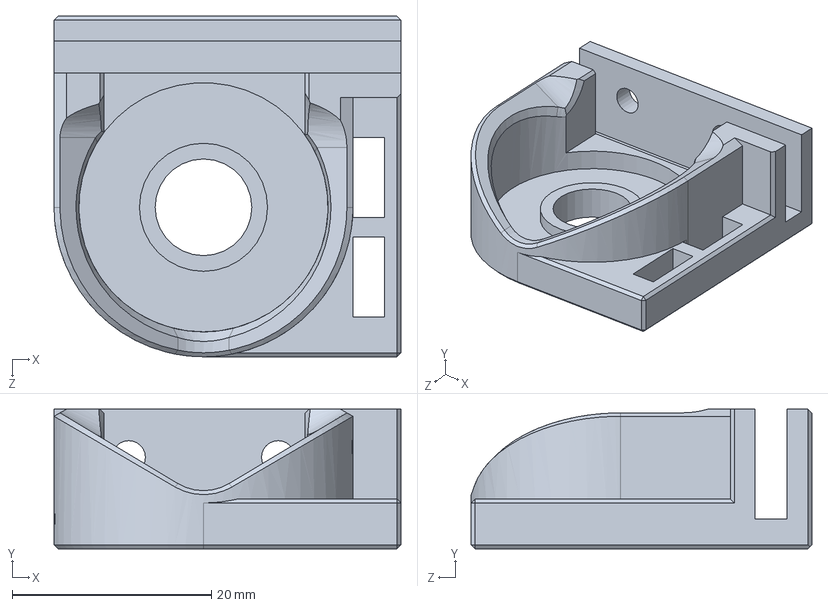
[picture p61: CAD file, 2024-03-23]
design_files/CAD/Parts/IdlePlateMirror.SLDPRT
34.8 x 14.0 x 34.2 mm
