callumberry/Mobile-Robot/design_files/3D_printing/3mf/mounts.3mf

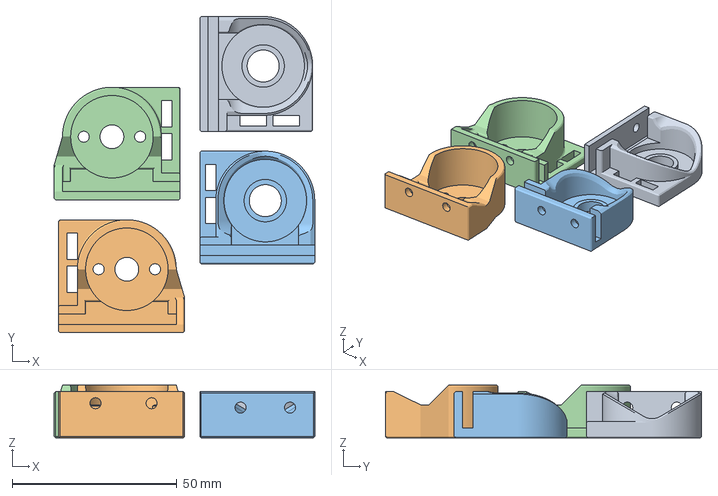
[picture p62: CAD file, 2024-03-12]
design_files/3D_printing/3mf/mounts.3mf
79.0 x 95.8 x 16.0 mm
IdlePlateFinalinsert x 2
MotorScrewPlateFinalgoodInseret x 2
