callumberry/Mobile-Robot/design_files/CAD/Current/ArmSupportGear.SLDPRT

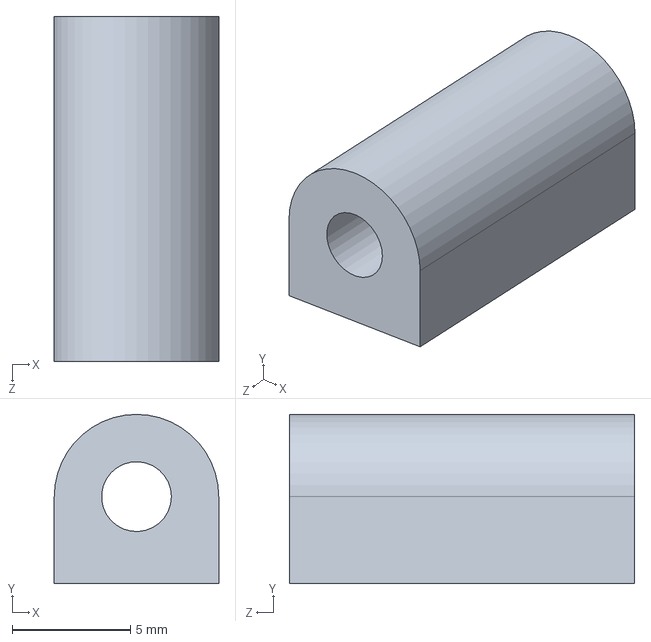
[picture p63: CAD file, 2024-03-31]
design_files/CAD/Current/ArmSupportGear.SLDPRT
6.95 x 7.15 x 14.6 mm
