callumberry/Mobile-Robot/design_files/CAD/Current/Arm/servoPlateOtherSide.SLDPRT

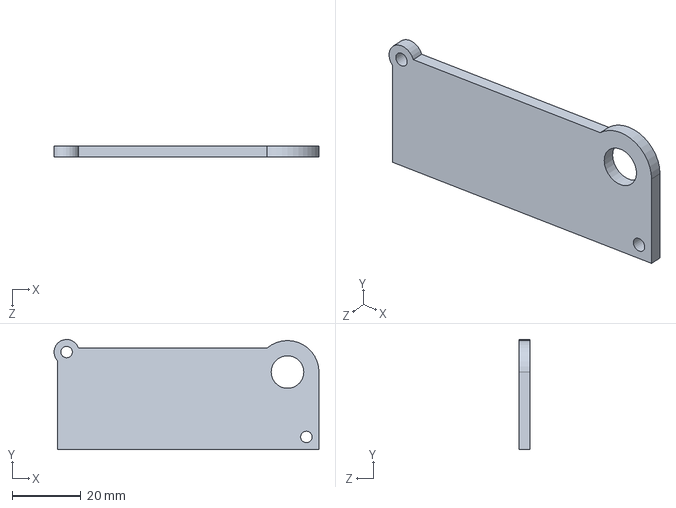
[picture p64: CAD file, 2024-03-31]
design_files/CAD/Current/Arm/servoPlateOtherSide.SLDPRT
77.2 x 32.1 x 3.17 mm
