callumberry/Mobile-Robot/design_files/CAD/Current/Gripper/fingerPlate.SLDPRT

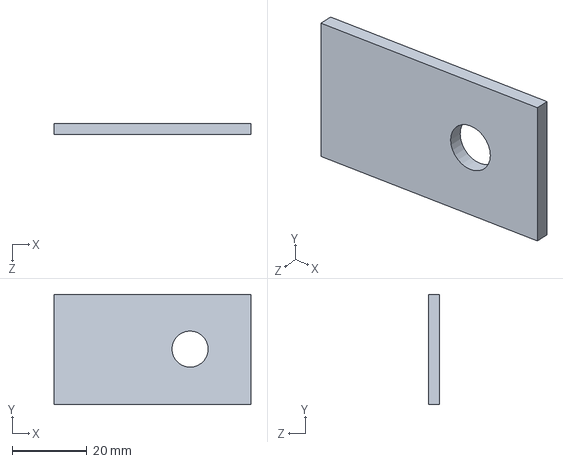
[picture p65: CAD file, 2024-03-31]
design_files/CAD/Current/Gripper/fingerPlate.SLDPRT
52.8 x 29.6 x 3.00 mm
