callumberry/Mobile-Robot/design_files/CAD/Parts/treadFake.SLDPRT

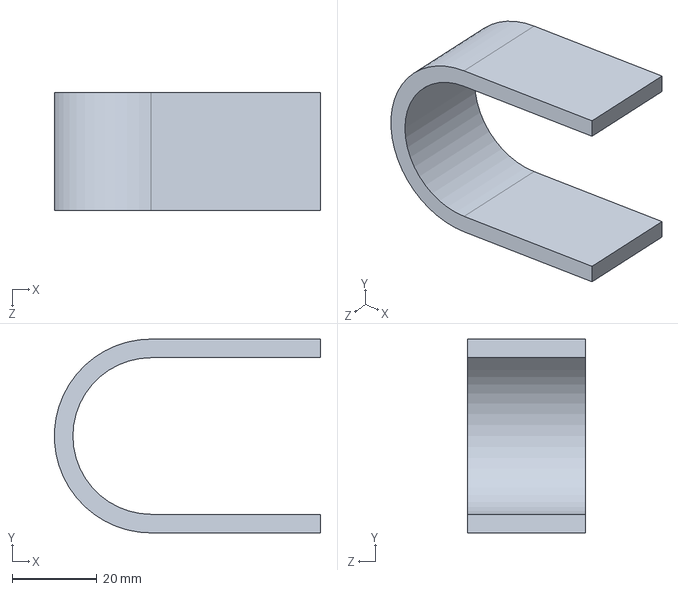
[picture p66: CAD file, 2024-03-23]
design_files/CAD/Parts/treadFake.SLDPRT
62.9 x 45.8 x 28.0 mm
