callumberry/Mobile-Robot/design_files/CAD/Current/Arm/gearSmall.SLDPRT

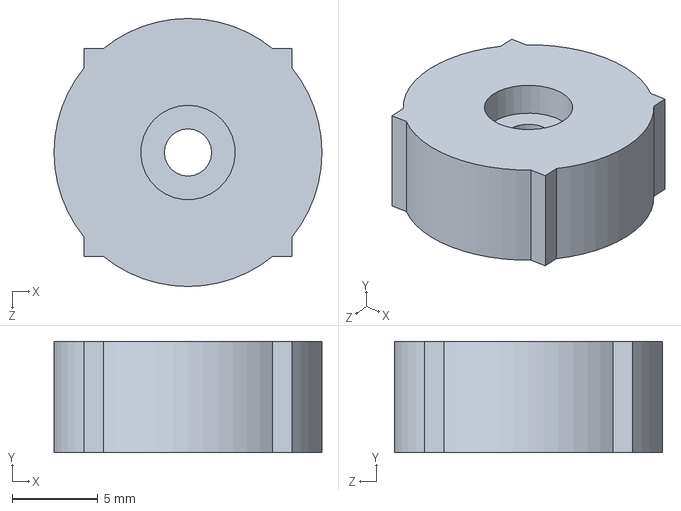
[picture p67: CAD file, 2024-03-31]
design_files/CAD/Current/Arm/gearSmall.SLDPRT
15.6 x 6.48 x 15.6 mm
