callumberry/Mobile-Robot/design_files/CAD/Current/Gripper/gripperMount.SLDPRT

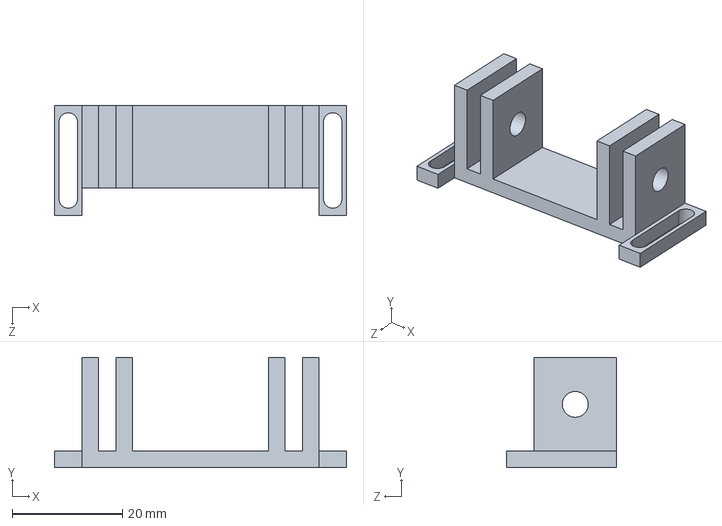
[picture p68: CAD file, 2024-03-31]
design_files/CAD/Current/Gripper/gripperMount.SLDPRT
53.0 x 20.0 x 20.0 mm
