callumberry/Mobile-Robot/design_files/CAD/Parts/frontSpacer.SLDPRT

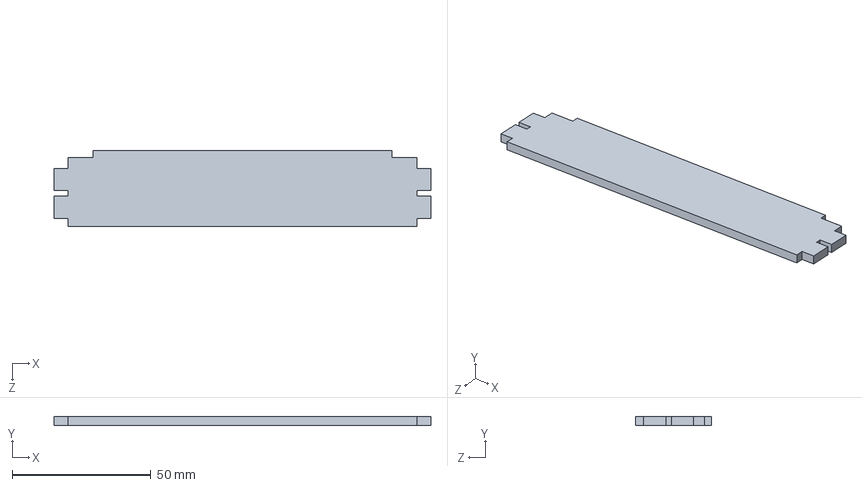
[picture p69: CAD file, 2024-03-23]
design_files/CAD/Parts/frontSpacer.SLDPRT
136.0 x 3.17 x 27.5 mm
