callumberry/Mobile-Robot/design_files/CAD/Current/Arm/GearPlate.SLDPRT

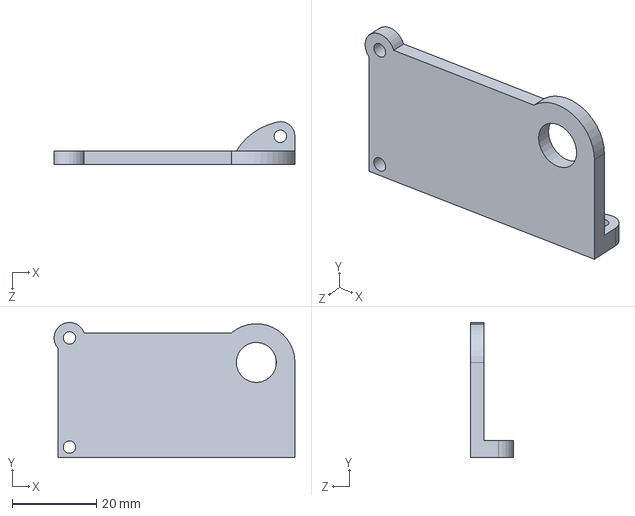
[picture p70: CAD file, 2024-03-31]
design_files/CAD/Current/Arm/GearPlate.SLDPRT
57.2 x 32.1 x 10.1 mm
