callumberry/Mobile-Robot/design_files/CAD/Current/Gripper/middleThing.SLDPRT

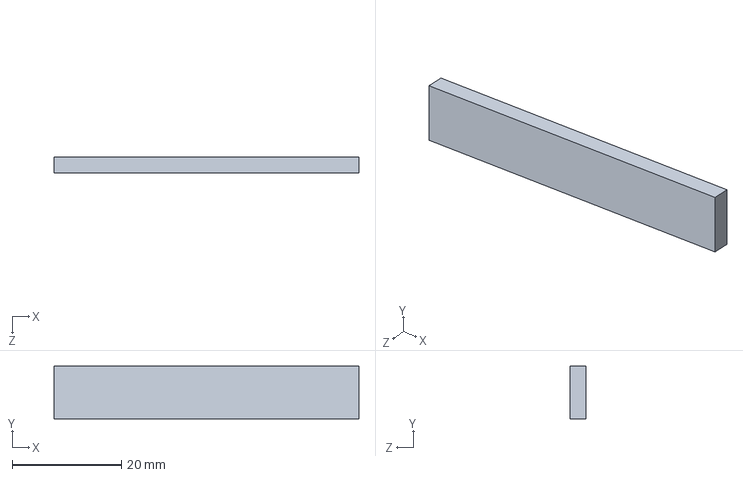
[picture p71: CAD file, 2024-03-31]
design_files/CAD/Current/Gripper/middleThing.SLDPRT
56.0 x 9.70 x 3.00 mm
