callumberry/Mobile-Robot/design_files/CAD/Parts/GrubTestFinal.SLDPRT

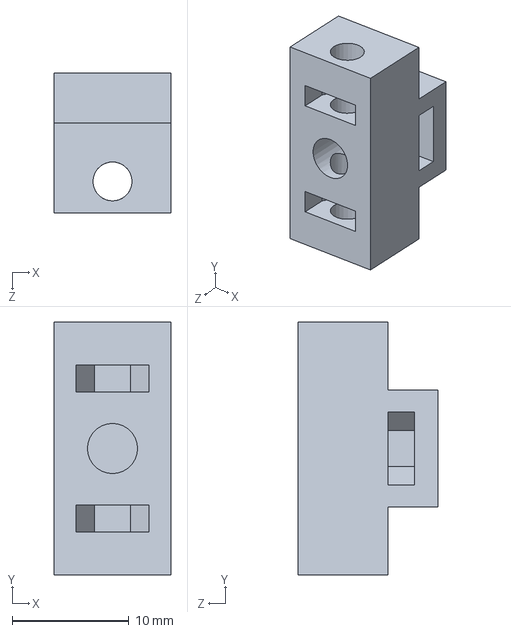
[picture p72: CAD file, 2024-03-23]
design_files/CAD/Parts/GrubTestFinal.SLDPRT
10.0 x 21.7 x 12.0 mm
