callumberry/Mobile-Robot/design_files/CAD/Current/Arm/baseArm.SLDPRT

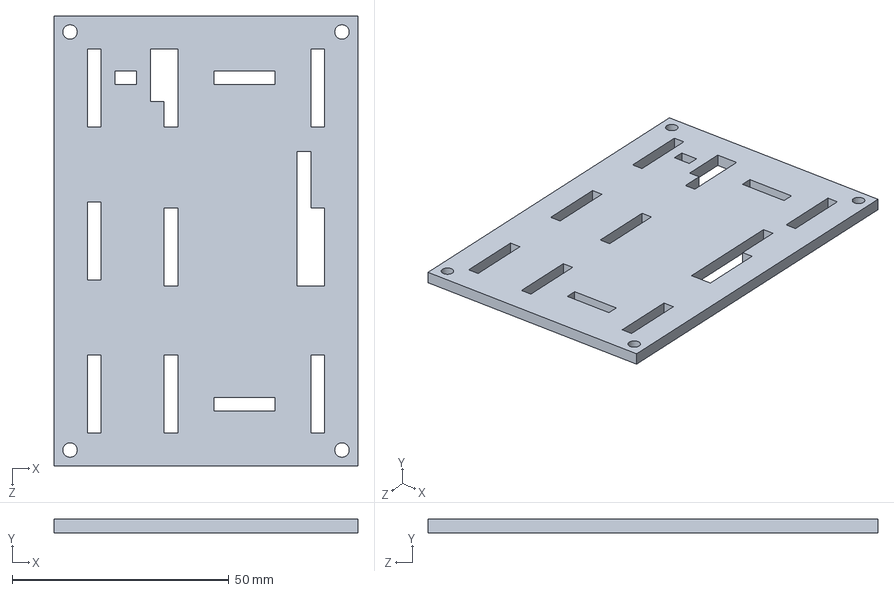
[picture p73: CAD file, 2024-03-31]
design_files/CAD/Current/Arm/baseArm.SLDPRT
70.1 x 3.17 x 103.9 mm
