callumberry/Mobile-Robot/design_files/CAD/Current/Gripper/smallGear.SLDPRT

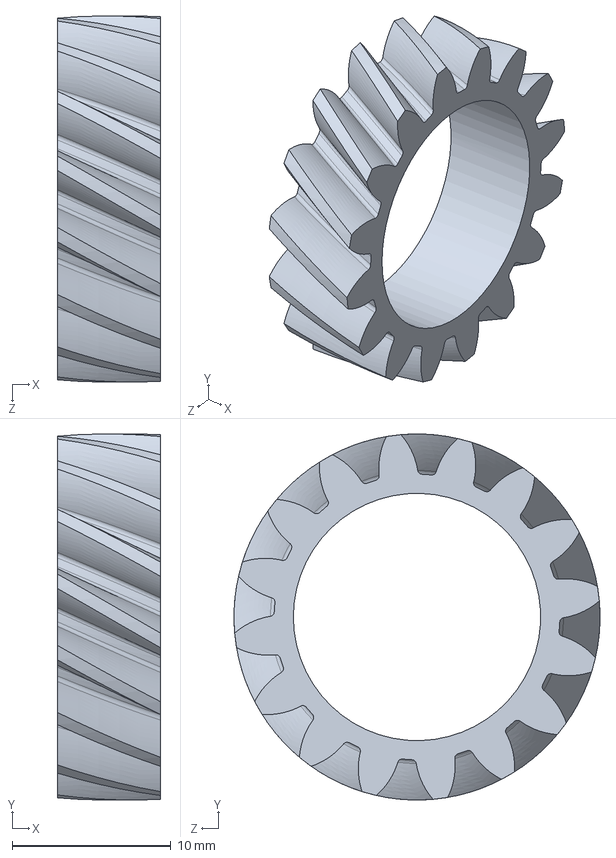
[picture p74: CAD file, 2024-03-31]
design_files/CAD/Current/Gripper/smallGear.SLDPRT
6.48 x 23.0 x 23.0 mm
