callumberry/Mobile-Robot/design_files/CAD/Parts/driveSupprtmiddle.SLDPRT

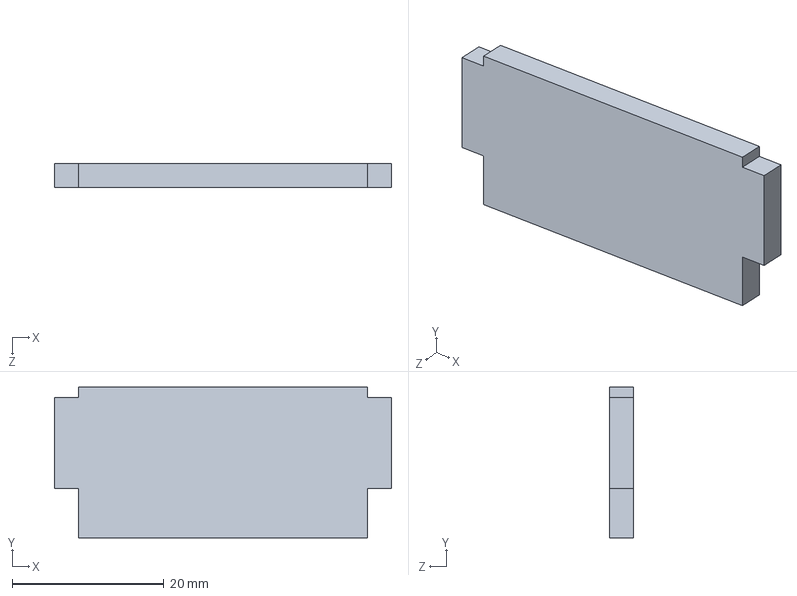
[picture p75: CAD file, 2024-03-23]
design_files/CAD/Parts/driveSupprtmiddle.SLDPRT
44.3 x 19.8 x 3.17 mm
