callumberry/Mobile-Robot/design_files/CAD/Current/Arm/actualGearboxSupport.SLDPRT

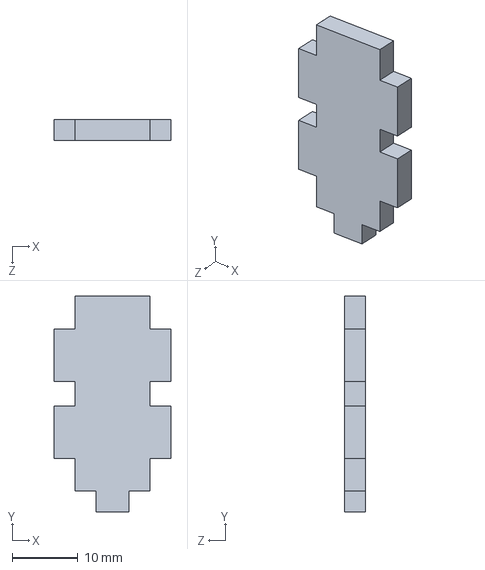
[picture p76: CAD file, 2024-03-23]
design_files/CAD/Current/Arm/actualGearboxSupport.SLDPRT
17.8 x 32.9 x 3.17 mm
