callumberry/Mobile-Robot/design_files/CAD/Parts/motorHelper.SLDPRT

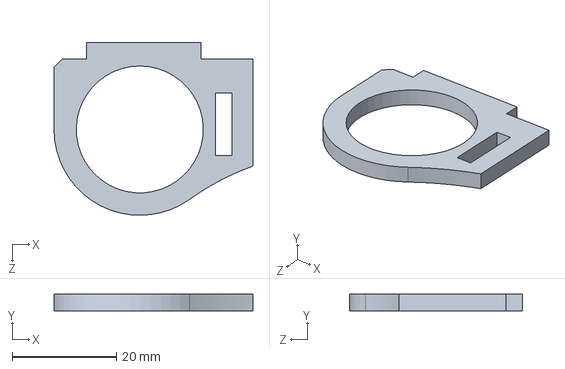
[picture p77: CAD file, 2024-03-23]
design_files/CAD/Parts/motorHelper.SLDPRT
38.3 x 3.17 x 33.2 mm
