callumberry/Mobile-Robot/design_files/CAD/Current/Arm/endcap.SLDPRT

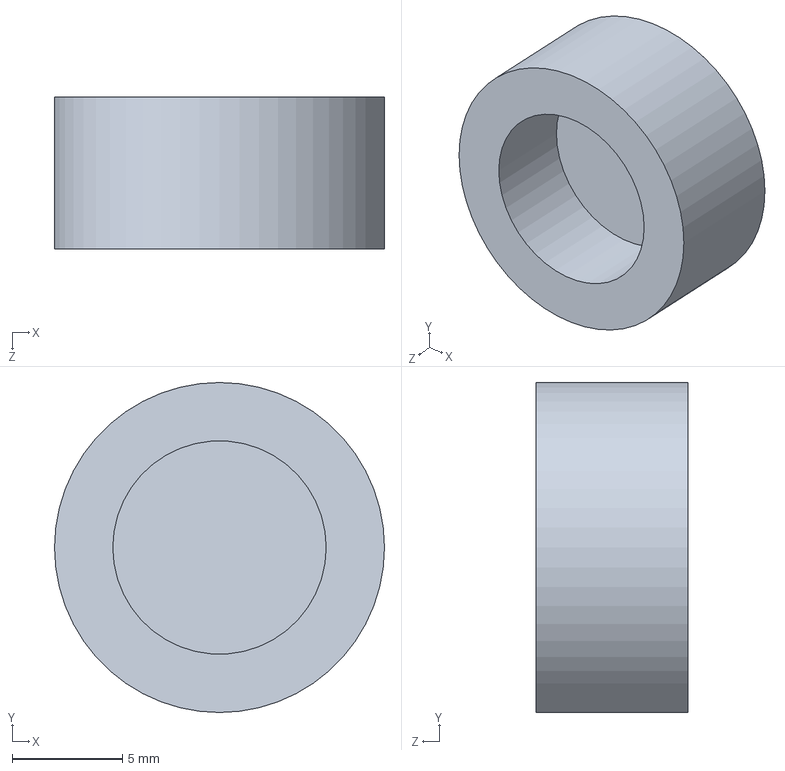
[picture p78: CAD file, 2024-03-23]
design_files/CAD/Current/Arm/endcap.SLDPRT
15.0 x 15.0 x 6.92 mm
