callumberry/Mobile-Robot/design_files/CAD/Parts/driveSupprt.SLDPRT

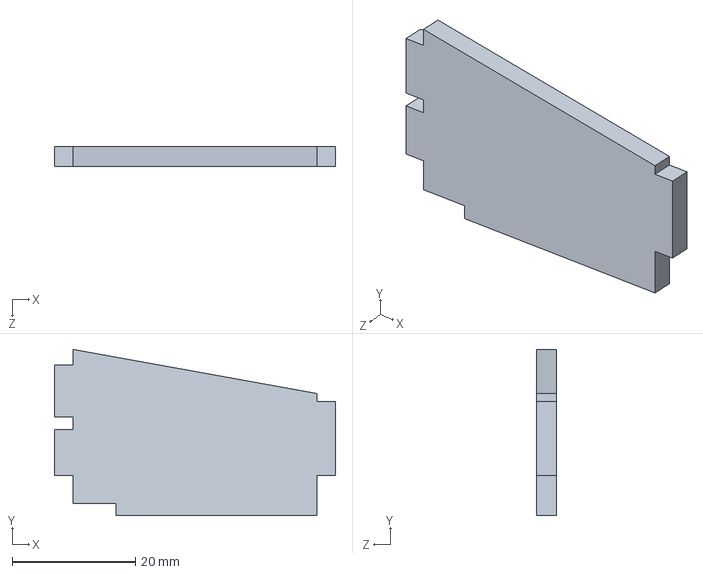
[picture p79: CAD file, 2024-03-23]
design_files/CAD/Parts/driveSupprt.SLDPRT
45.7 x 27.0 x 3.17 mm
