callumberry/Mobile-Robot/design_files/CAD/Current/Arm/servoHolder.SLDPRT

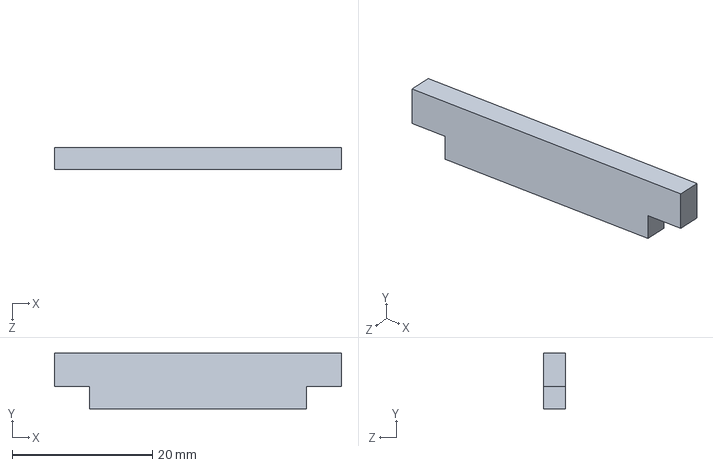
[picture p80: CAD file, 2024-03-23]
design_files/CAD/Current/Arm/servoHolder.SLDPRT
41.0 x 7.96 x 3.17 mm
