callumberry/Mobile-Robot/design_files/CAD/Current/Arm/rod2.SLDPRT

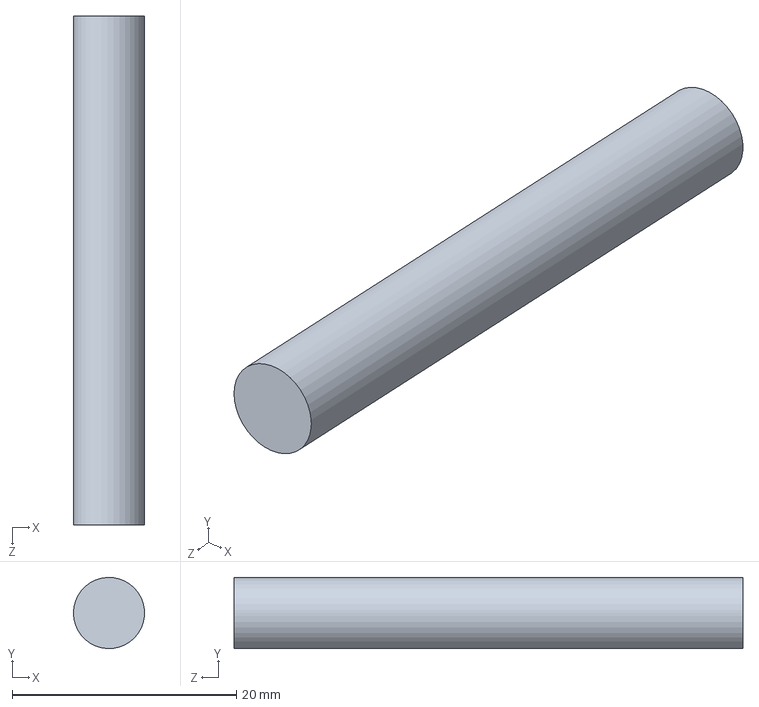
[picture p81: CAD file, 2024-03-23]
design_files/CAD/Current/Arm/rod2.SLDPRT
6.35 x 6.34 x 45.4 mm
