callumberry/Mobile-Robot/design_files/CAD/Current/Arm/otherSidePlate.SLDPRT

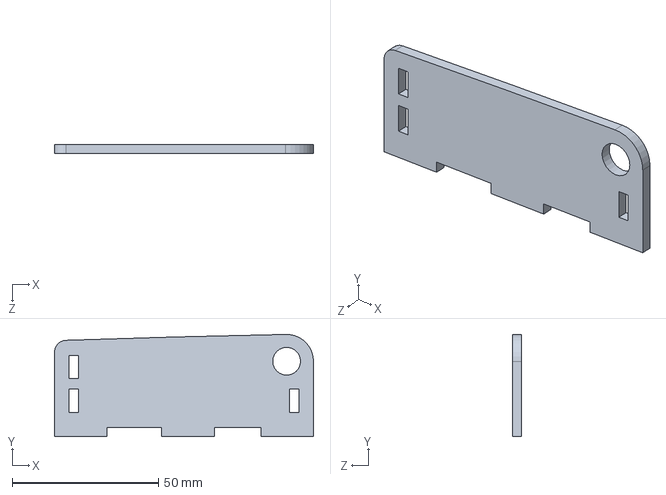
[picture p82: CAD file, 2024-03-23]
design_files/CAD/Current/Arm/otherSidePlate.SLDPRT
88.6 x 34.9 x 3.17 mm
