callumberry/Mobile-Robot/design_files/CAD/Parts/BatteryHolder.SLDPRT

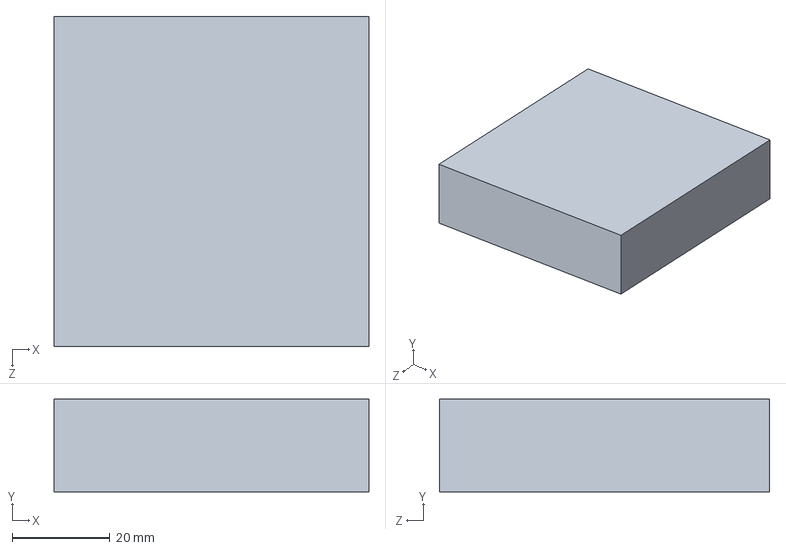
[picture p83: CAD file, 2024-01-29]
design_files/CAD/Parts/BatteryHolder.SLDPRT
64.6 x 19.0 x 67.8 mm
