callumberry/Mobile-Robot/design_files/CAD/Current/Arm/backGearSupport.SLDPRT

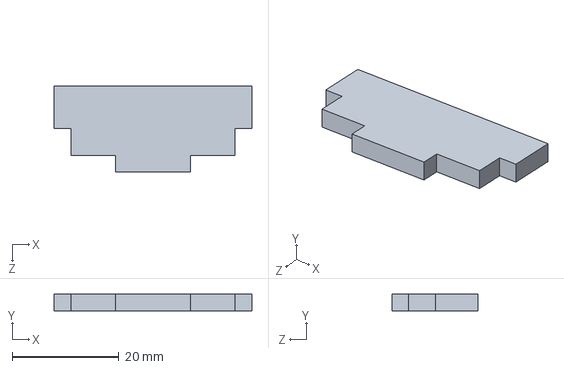
[picture p84: CAD file, 2024-03-23]
design_files/CAD/Current/Arm/backGearSupport.SLDPRT
37.0 x 3.17 x 16.2 mm
