callumberry/Mobile-Robot/design_files/CAD/Parts/BreadboardSmall.SLDPRT

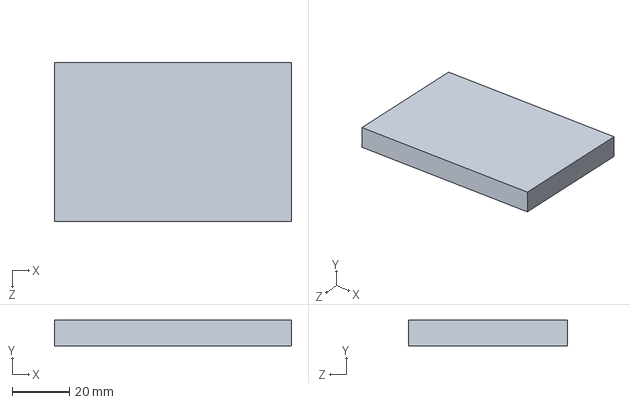
[picture p85: CAD file, 2024-01-29]
design_files/CAD/Parts/BreadboardSmall.SLDPRT
82.9 x 9.00 x 55.6 mm
