callumberry/Mobile-Robot/design_files/CAD/Current/Arm/leftPlate.SLDPRT

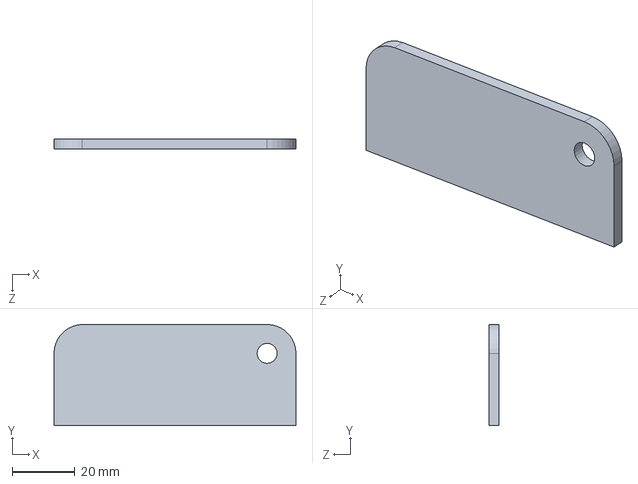
[picture p86: CAD file, 2024-03-23]
design_files/CAD/Current/Arm/leftPlate.SLDPRT
76.9 x 32.1 x 3.17 mm
