callumberry/Mobile-Robot/design_files/CAD/Current/Arm/gearbox support.SLDPRT

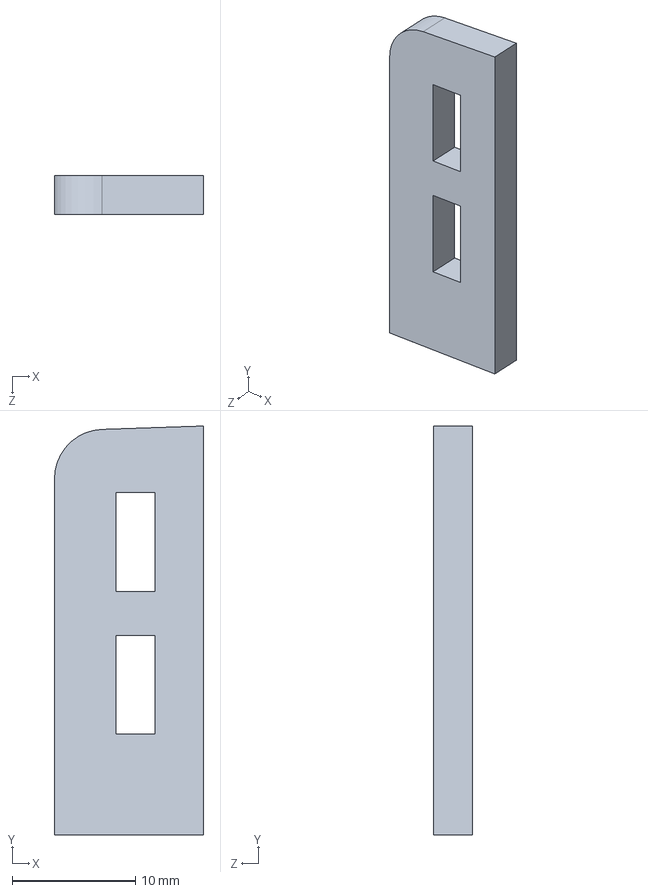
[picture p87: CAD file, 2024-03-23]
design_files/CAD/Current/Arm/gearbox support.SLDPRT
12.1 x 33.2 x 3.17 mm
