callumberry/Mobile-Robot/design_files/CAD/Current/Arm/backServoSupport.SLDPRT

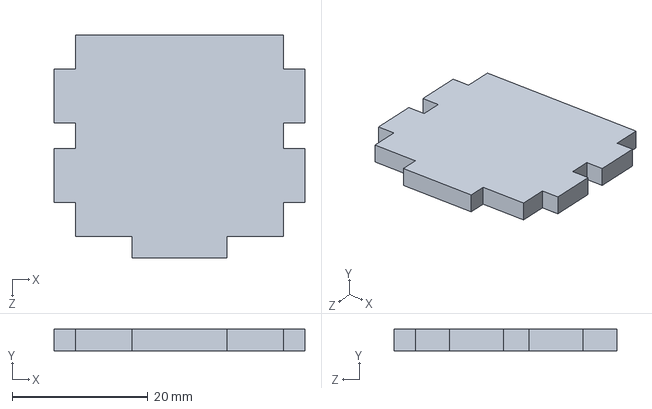
[picture p88: CAD file, 2024-03-23]
design_files/CAD/Current/Arm/backServoSupport.SLDPRT
37.0 x 3.17 x 32.9 mm
