callumberry/Mobile-Robot/design_files/CAD/Current/Arm/horn.SLDPRT

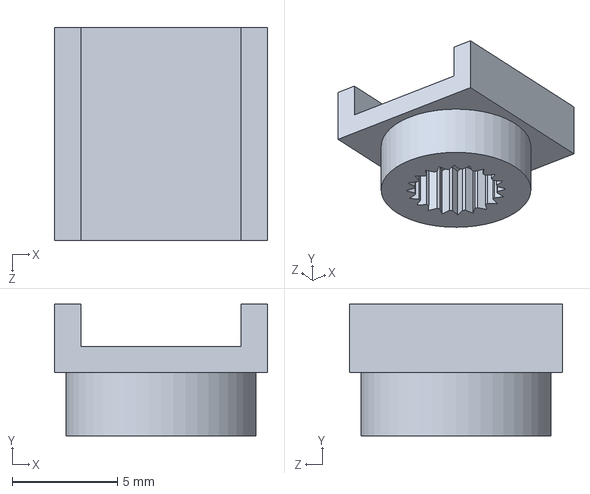
[picture p89: CAD file, 2024-03-23]
design_files/CAD/Current/Arm/horn.SLDPRT
10.1 x 6.25 x 10.1 mm
