callumberry/Mobile-Robot/design_files/CAD/Current/Arm/rod1.SLDPRT

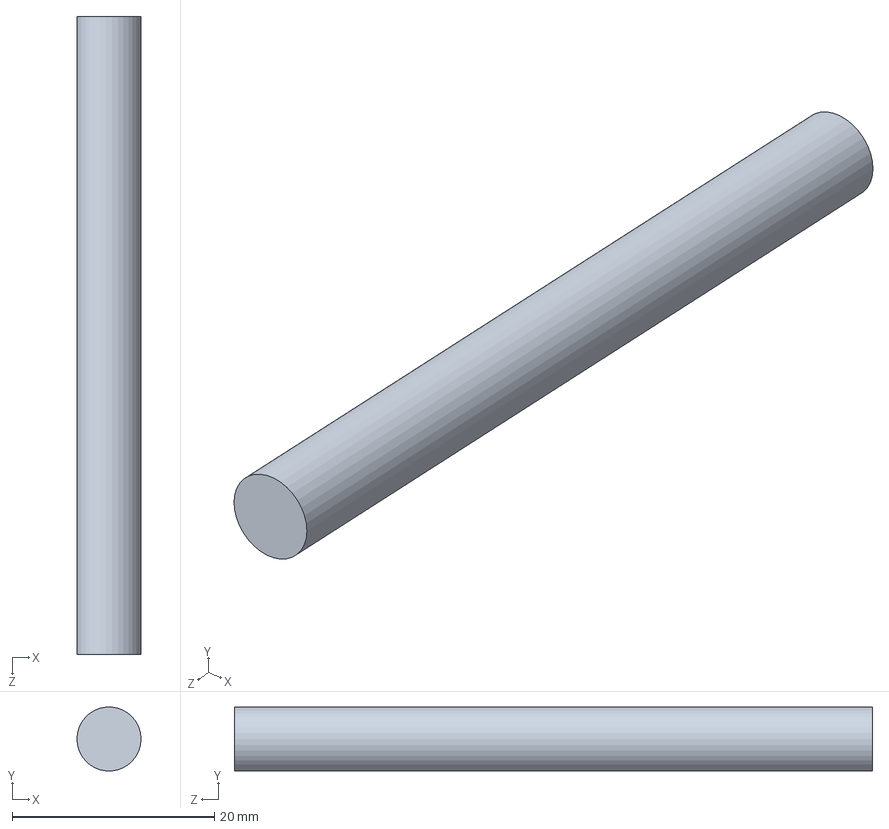
[picture p90: CAD file, 2024-03-23]
design_files/CAD/Current/Arm/rod1.SLDPRT
6.35 x 6.32 x 63.1 mm
