callumberry/Mobile-Robot/design_files/CAD/Current/Arm/armSupport.SLDPRT

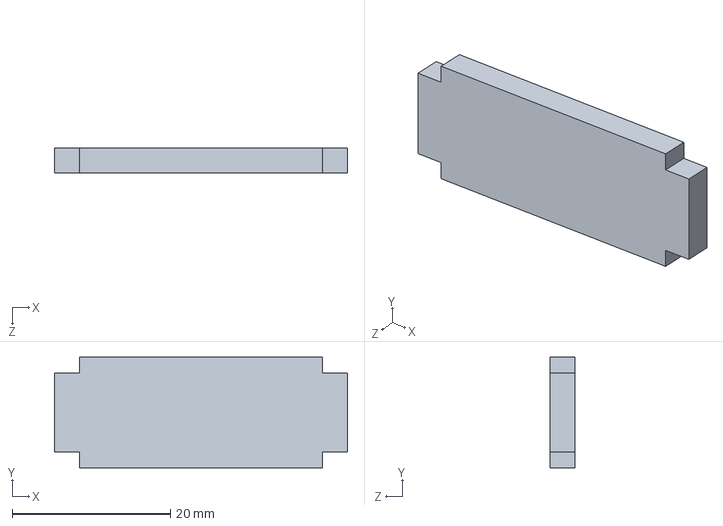
[picture p91: CAD file, 2024-03-23]
design_files/CAD/Current/Arm/armSupport.SLDPRT
37.0 x 14.0 x 3.17 mm
