callumberry/Mobile-Robot/design_files/CAD/Current/Arm/linkage.SLDPRT

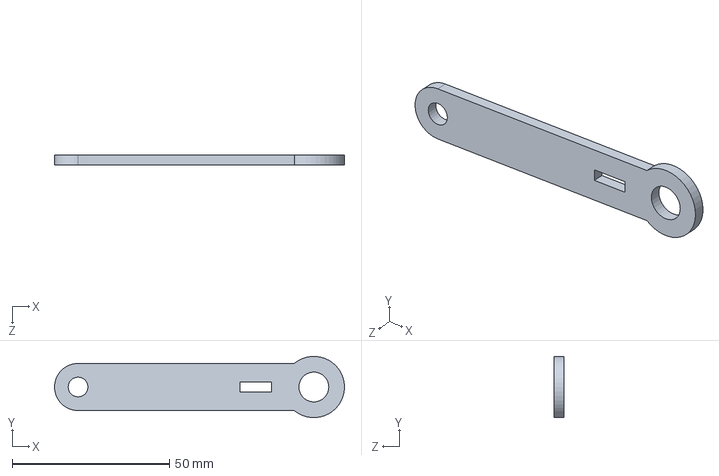
[picture p92: CAD file, 2024-03-23]
design_files/CAD/Current/Arm/linkage.SLDPRT
92.2 x 19.5 x 3.17 mm
