callumberry/Mobile-Robot/design_files/CAD/Current/Arm/Pit.SLDPRT

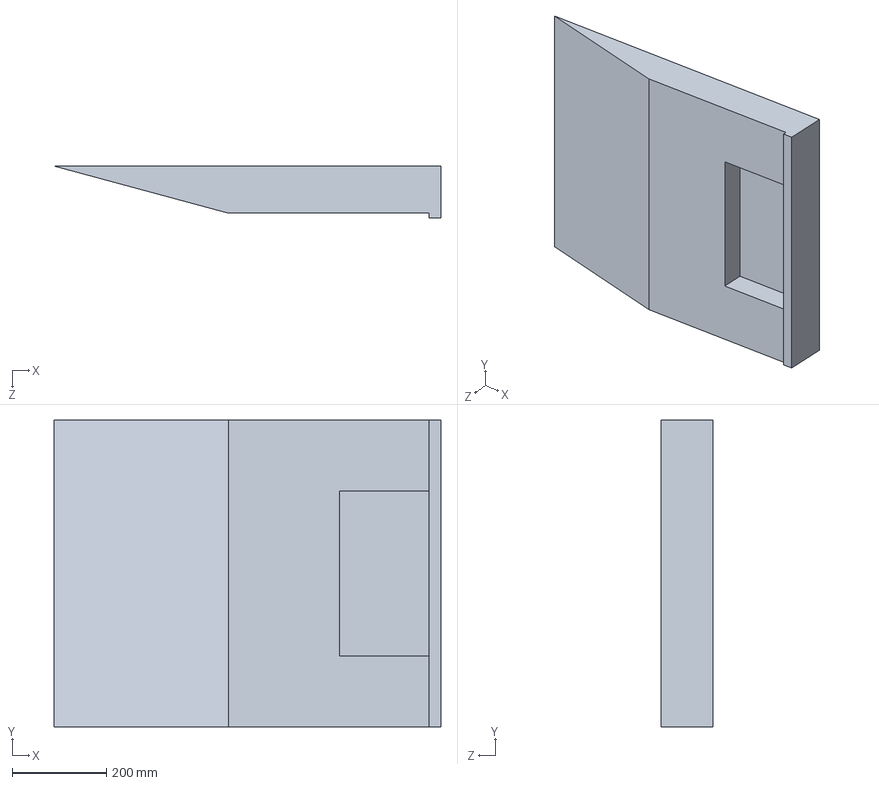
[picture p93: CAD file, 2024-03-23]
design_files/CAD/Current/Arm/Pit.SLDPRT
820.0 x 650.0 x 110.0 mm
