callumberry/Mobile-Robot/design_files/CAD/Assemblies/IdleWheel.SLDASM

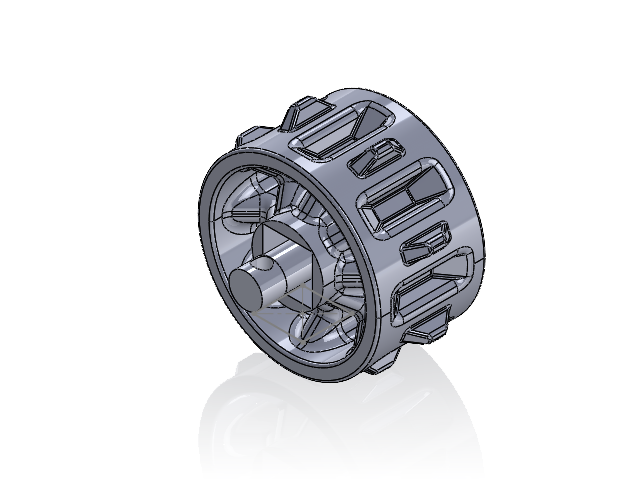
[picture p94: CAD file, 2024-03-23]
design_files/CAD/Assemblies/IdleWheel.SLDASM
idleWheelFinal
IdleGrubTest
