callumberry/Mobile-Robot/design_files/CAD/Current/Arm/motorGear.SLDASM

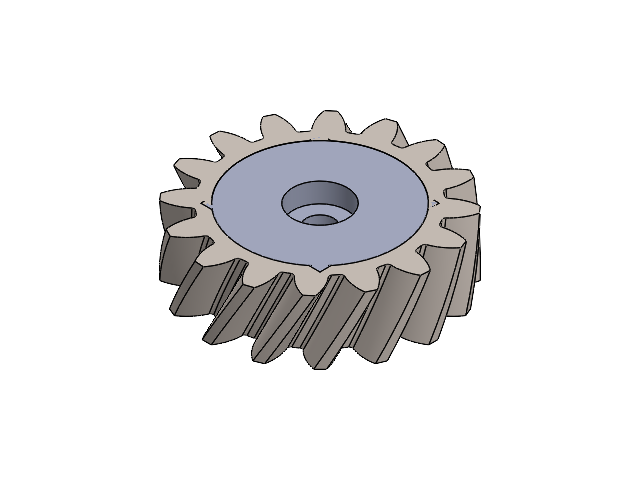
[picture p95: CAD file, 2024-03-31]
design_files/CAD/Current/Arm/motorGear.SLDASM
gearSmall
helical gear_4_iso
