callumberry/Mobile-Robot/design_files/CAD/Assemblies/DriveWheel.SLDASM

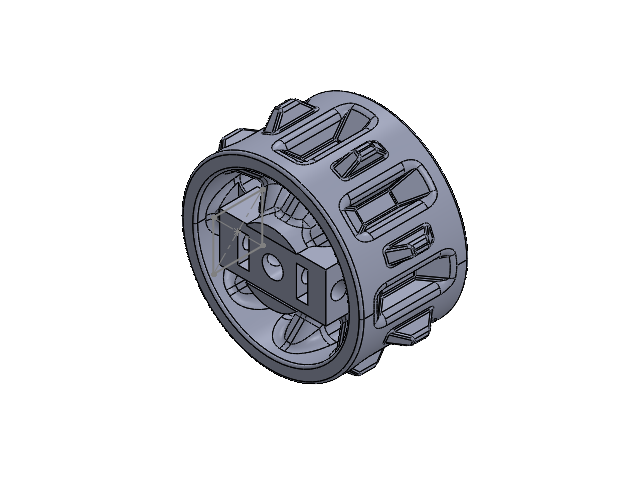
[picture p96: CAD file, 2024-03-23]
design_files/CAD/Assemblies/DriveWheel.SLDASM
driveWheelFinal
GrubTestFinal
