callumberry/Mobile-Robot/(list of files, cad)

Other CAD files:
design_files/laser_cutting/DWG/Chassis_baseV2.DWG
design_files/laser_cutting/DWG/Chassis.dwg
design_files/laser_cutting/DWG/arm.DWG
design_files/CAD/Parts/IdlePlateFinal.SLDPRT
design_files/3D_printing/3mf/Treads.3mf
design_files/CAD/Current/Arm/rightSidePlate.SLDPRT
design_files/CAD/Current/Arm/servoPlate.SLDPRT
design_files/CAD/Current/ArmSupportGearScrew.SLDPRT
design_files/CAD/Current/Gripper/sleeve.SLDPRT
design_files/CAD/Parts/MotorScrewPlateFinal.SLDPRT
design_files/CAD/Parts/MotorScrewPlatev4goodMirror.SLDPRT
design_files/CAD/Xtra/ToleranceTests/MotorScrewPlatev2.SLDPRT
design_files/CAD/Xtra/ToleranceTests/screwTest.SLDPRT
