callumberry/Mobile-Robot/design_files/3D_printing/README.md

[Home](main)

# 3D Printing Tally
| Part | Volume | Percent |
|---|---|---|
| Wheels | 2.25 in<sup>3</sup>| 15 %|
| Treads (x2) | 3.36 in<sup>3</sup>  | 22.4 % |
| Mounts | 1.13 in<sup>3</sup>| 7.5 % |
| Idle Wheel Shafts V2 | 0.16 in<sup>3</sup>| 1.07 % |
| LFM V1 | 0.07 in<sup>3</sup>| 0.47 % |
| LFM V2 | 0.08 in<sup>3</sup>| 0.53 % |
| Arm V2 | 2.84 in<sup>3</sup>| 18.93 % |
| Claw | 1.39 in<sup>3</sup>| 9.27 % |
| Idle Claw Pincers V2 | 0.26 in<sup>3</sup>| 1.73 % |
| TPU Sleeve | 0.59 in<sup>3</sup>| 3.93 % |
| Total | 12.13 in<sup>3</sup>| 80.87 %|

treads and wheels modified from this design: https://www.thingiverse.com/thing:430305.

# Pictures
## Wheels
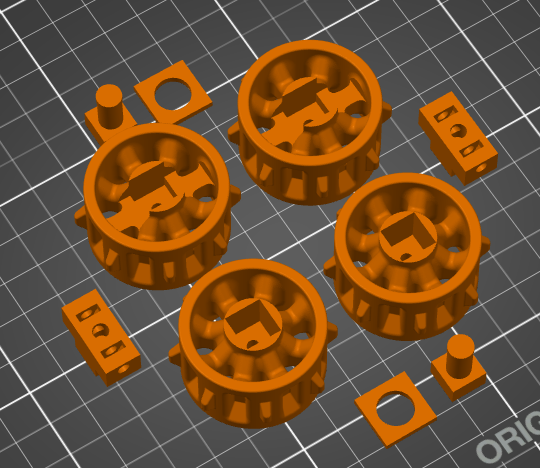
[picture p97: images/3mf/wheels.png]


## Mounts
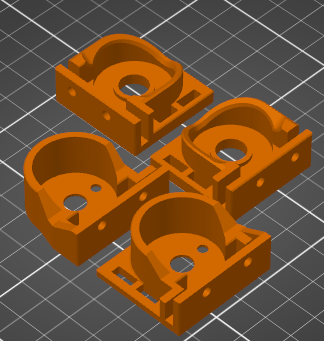
[picture p98: images/3mf/mounts.png]


## Treads
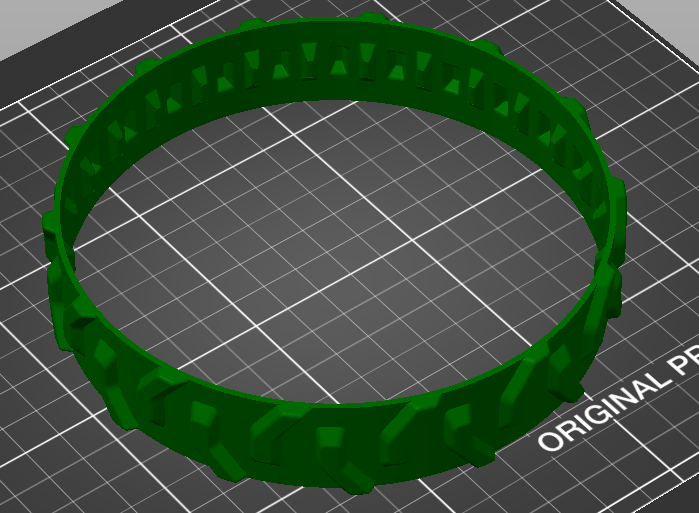
[picture p99: images/3mf/treads.png]


## Idle Wheel Shafts V2
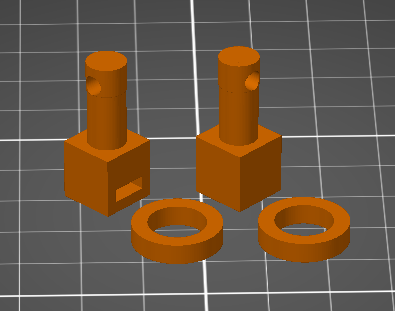
[picture p100: images/3mf/idleShaftV2.png]


## Line Following Mounts V1
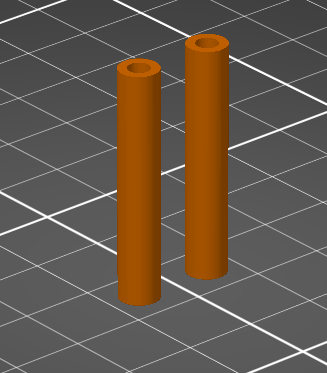
[picture p101: images/3mf/sensorV1.png]


## Line Following Mounts V2
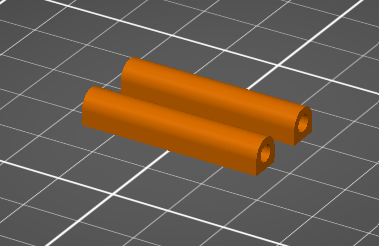
[picture p102: images/3mf/sensorV2.png]


## Arm V2
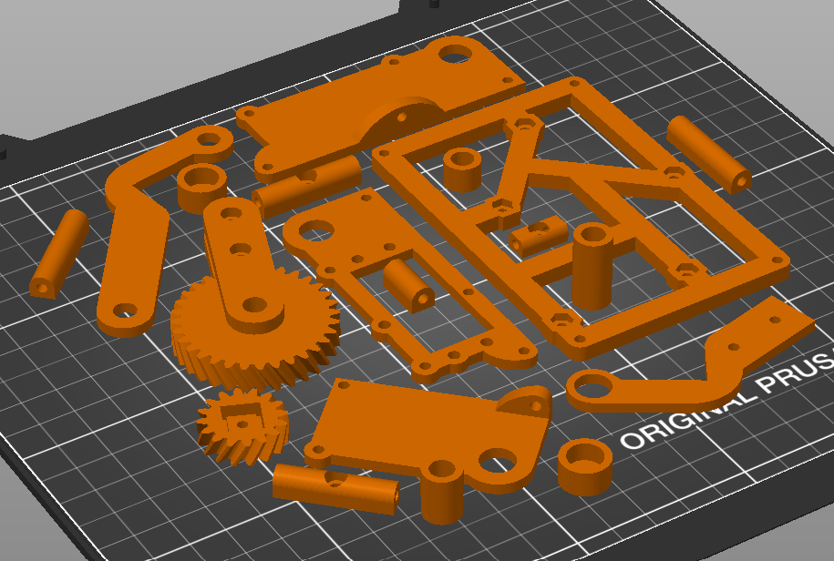
[picture p103: images/3mf/armV2.png]


## Claw
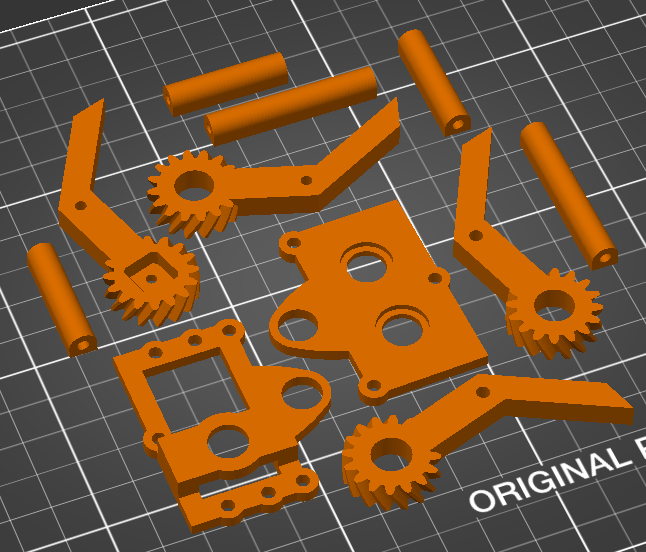
[picture p104: images/3mf/claw.png]


## Idle Claw Pincers V2
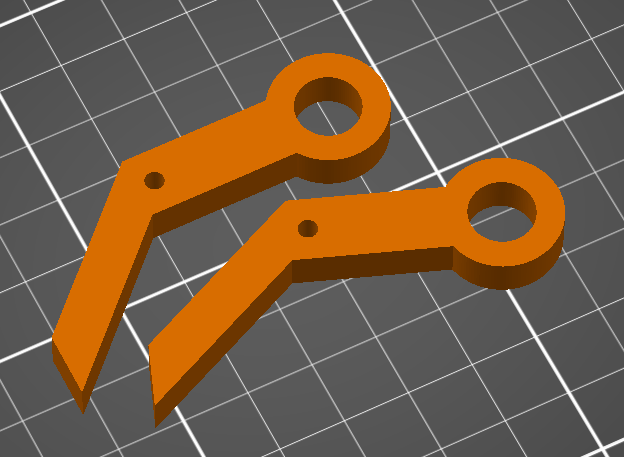
[picture p105: images/3mf/idlePincers.png]


## TPU Sleeve
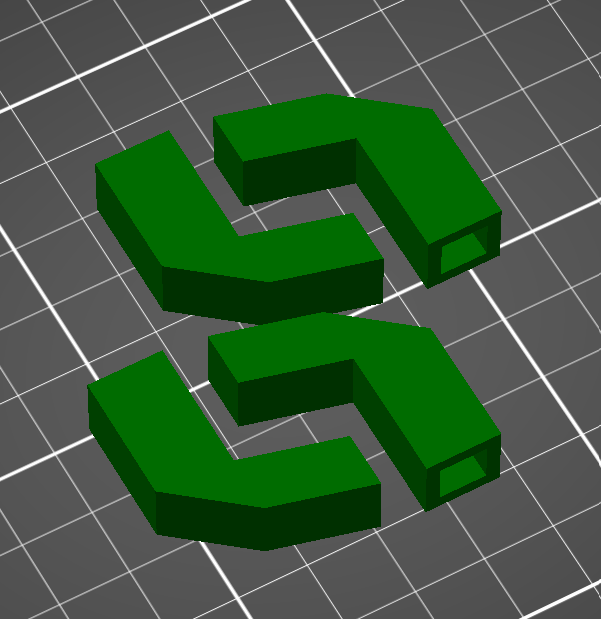
[picture p106: images/3mf/sleeves.png]
