callumberry/Mobile-Robot/(commit log)

2024-01-29 added code an cad
2024-01-29 added ultrasonic.txt
2024-01-29 added cad properly
    [BatteryHolder.SLDPRT, BreadboardSmall.SLDPRT, ChassisBottom.SLDPRT, DC_Motor.SLDPRT, HS-422_Servo.SLDPRT, MotorDriver.SLDPRT, Tread.SLDPRT, TreadAssembly.SLDASM]
2024-01-30 renamed servo ino file
2024-01-30 added dc motor test
2024-02-05 Upload New File
    [Week_4_Workshop_2_-_FRDPARRC_Table.xlsx]
2024-02-06 added ultrasonic image
2024-02-06 changed pin number
2024-02-06 3d printing reference
2024-02-06 both motors spin
2024-02-26 organized and started
    [Treads.3mf]
2024-02-26 removed CAD folder
    [BatteryHolder.SLDPRT, BreadboardSmall.SLDPRT, ChassisBottom.SLDPRT, DC_Motor.SLDPRT, HS-422_Servo.SLDPRT, MotorDriver.SLDPRT, Tread.SLDPRT, TreadAssembly.SLDASM]
2024-02-26 Reorganized folders and added cad
    [BatteryHolder.SLDPRT, BreadboardSmall.SLDPRT, HS-422_Servo.SLDPRT, MotorDriver.SLDPRT, Week_4_Workshop_2_-_FRDPARRC_Table.xlsx]
2024-03-12 added 3d models
    [mounts.3mf]
2024-03-23 added print tally
2024-03-23 added home button
2024-03-23 added cad and readme files
    [BatteryHolder.SLDPRT, BreadboardSmall.SLDPRT, ChassisTopIncomplete.SLDPRT, DC_Motor.SLDPRT, DriveTrain.SLDASM, DriveWheel.SLDASM, Gearlinkage.SLDPRT, Gripper2.SLDASM]
2024-03-23 added images to 3d printing tally
    [Treads.3mf, mounts.3mf]
2024-03-23 added images
    [Chassis.dwg, arm.DWG, baseArmV2.DWG, combined.DWG, frontSupport.dwg, middleBackSupport.dwg, motorSupport.dwg, sideBackSupport.dwg]
2024-03-23 fixed arm pictures assembly
2024-03-31 re-organized file structure
    [Treads.3mf, mounts.3mf]
2024-03-31 various updates
    [ArmSupport.SLDPRT, ArmSupportGear.SLDPRT, ArmSupportGearScrew.SLDPRT, ChassisTopIncomplete.SLDPRT, Chassis_baseV2.DWG, GearPlate.SLDPRT, Gearlinkage.SLDPRT, Gripper2.SLDASM]
2024-03-31 updated 3d printing
    [idleShaftV2.3mf, sensorV1.3mf]
2024-03-31 completed printing tally
    [armV2.3mf, claw.3mf, idlePincers.3mf, sleeves.3mf]
2024-03-31 added prototype to main page
2024-03-31 reorganized image structure
    [Week_4_Workshop_2_-_FRDPARRC_Table.xlsx]
2024-03-31 reorganized images
    [Week_4_Workshop_2_-_FRDPARRC_Table.xlsx]
